zeridon/video/hardware/frontplate/README.md

# Front plate

The front plate is lasercut out of 2.5mm MDF sheets. The script below will
generate an SVG with a unique QR code for each panel, and combine 7 of them
on one sheet for easy processing.

	# requirements:
	#
	# inkscape         https://archlinux.org/packages/extra/x86_64/inkscape/
	# xmlstarlet       https://archlinux.org/packages/extra/x86_64/xmlstarlet/
	# python-qrcode    https://archlinux.org/packages/extra/any/python-qrcode/
	# python-svgutils  https://aur.archlinux.org/packages/python-svgutils
	
	# assumptions:
	# - the frontplate.svg file is a template for a front plate
	# - this template contains elements with id box-qr and box-label
	
	for i in {0..69}; do ./generate.sh A $i; done;

	max=69
	
	for i in $(seq 0 6 $max); do
		end=$(($i+5))
	
		list=""
		for j in $(seq $i $end); do
			if [ $j -gt $max ]; then
				break
			fi
	
			id=$(printf %03d $j)
			list="$list A$id"
		done
	
		./combine.py $list
	done
