zeridon/video/hardware/pcbs/audio_board/README.md

# audio board

Built-in digital audio mixer board.

* Based on the Teensy 4.1 as audio DSP
* Stereo audio input and output over USB
* Four input channels
  * 3 balanced XLR inputs for line level signals
  * One stereo 3.5mm jack with mono summing
* Four output channels
  * Two balanced XLR outputs
  * Two outputs used as stereo headphones output
