zeridon/video/graph/cabling_large_rooms.png

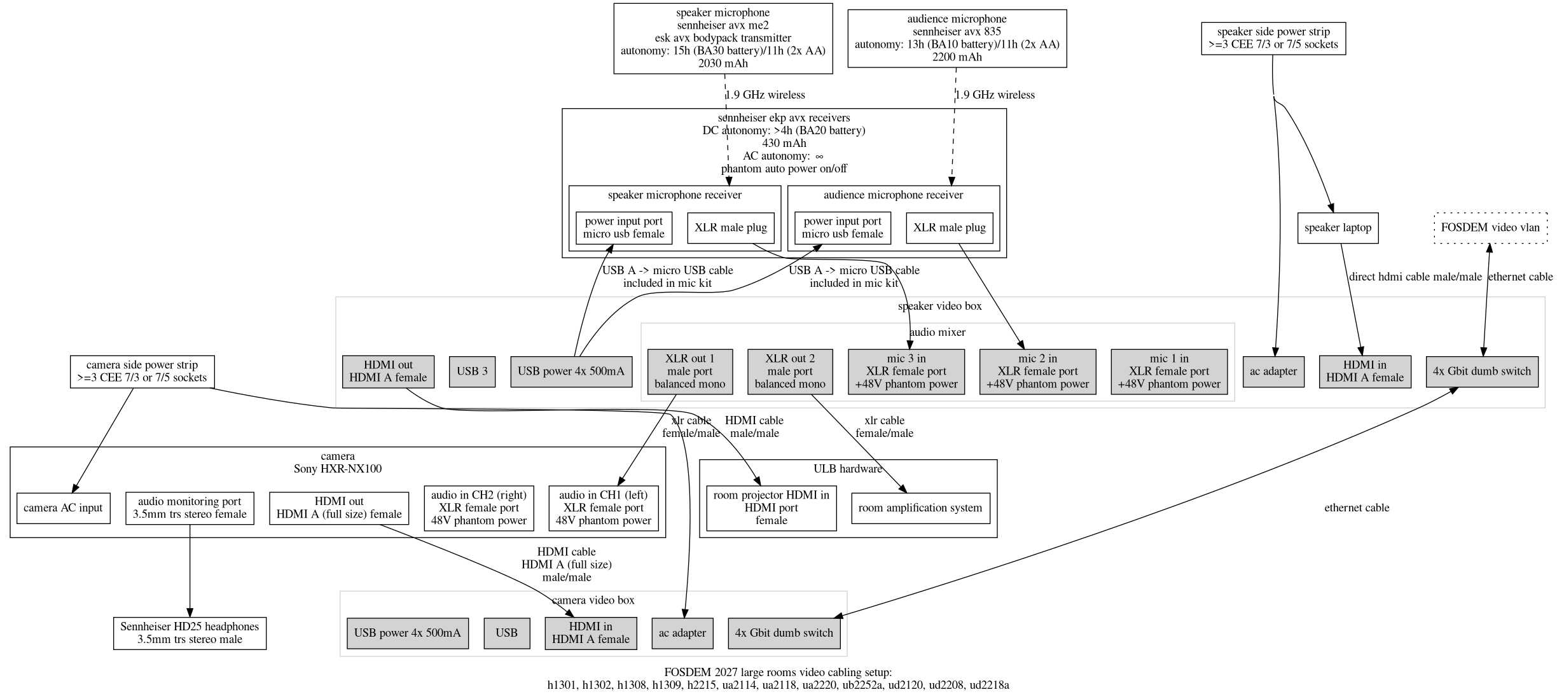
graph/cabling_large_rooms.png
