zeridon/video/graph/cabling_small_rooms.png

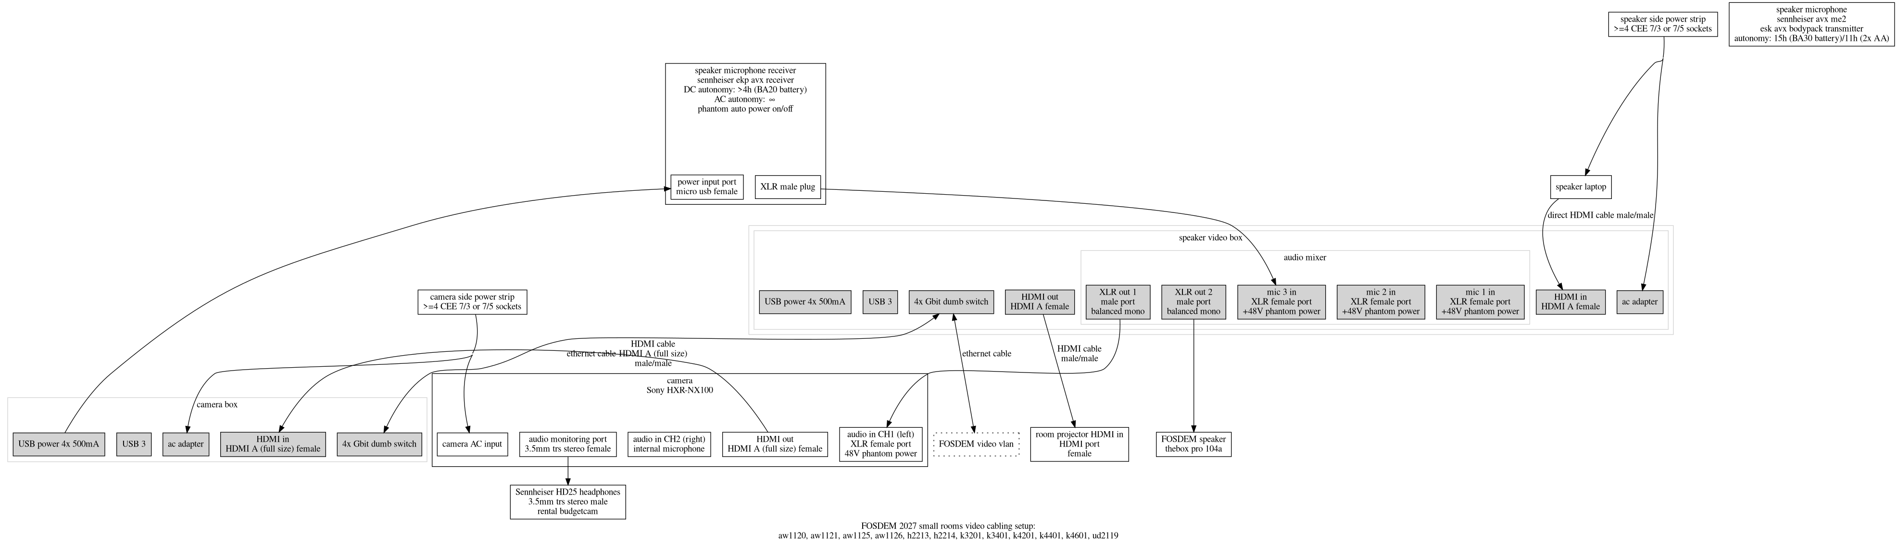
graph/cabling_small_rooms.png
