zeridon/video/graph/cabling_xxl_rooms.png

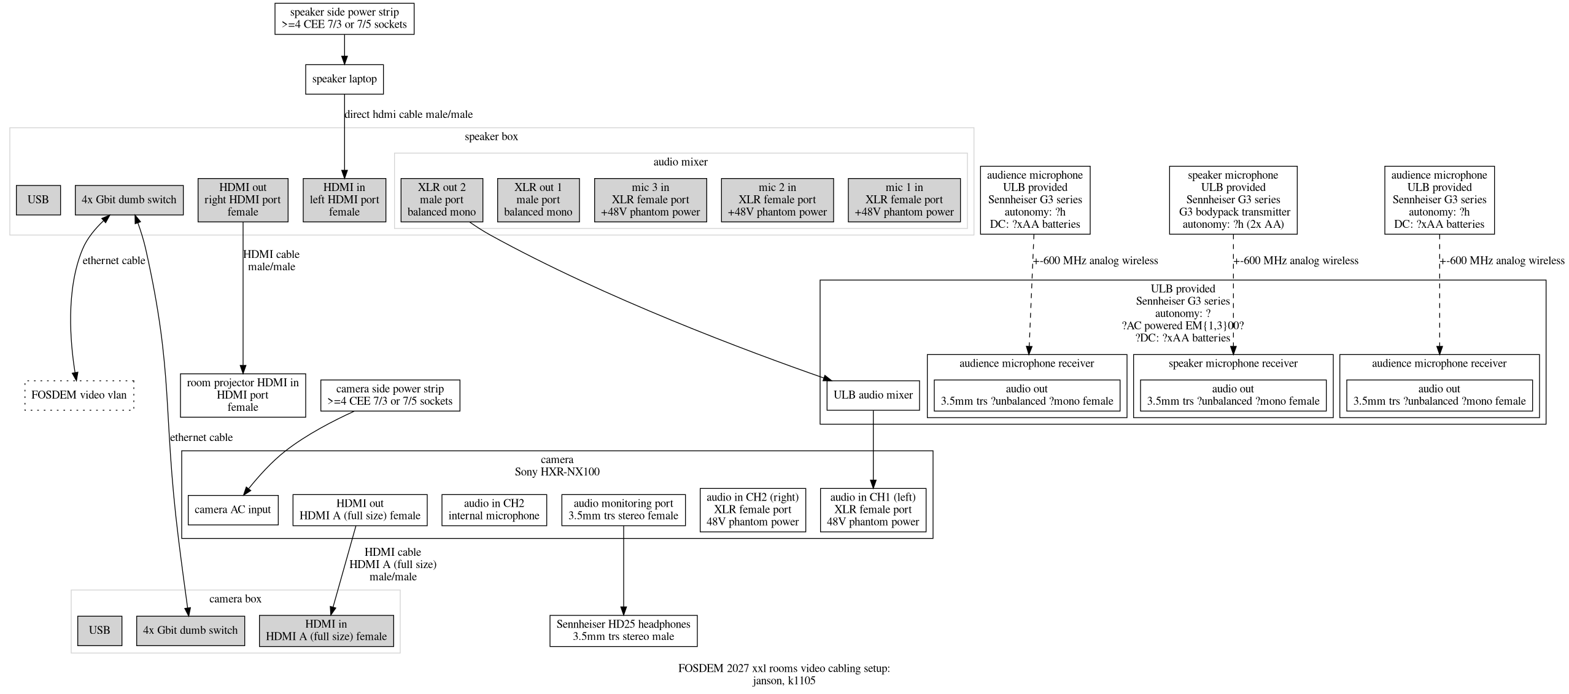
graph/cabling_xxl_rooms.png
