zeridon/video/hardware/ethernet/i2c-pinout.jpg

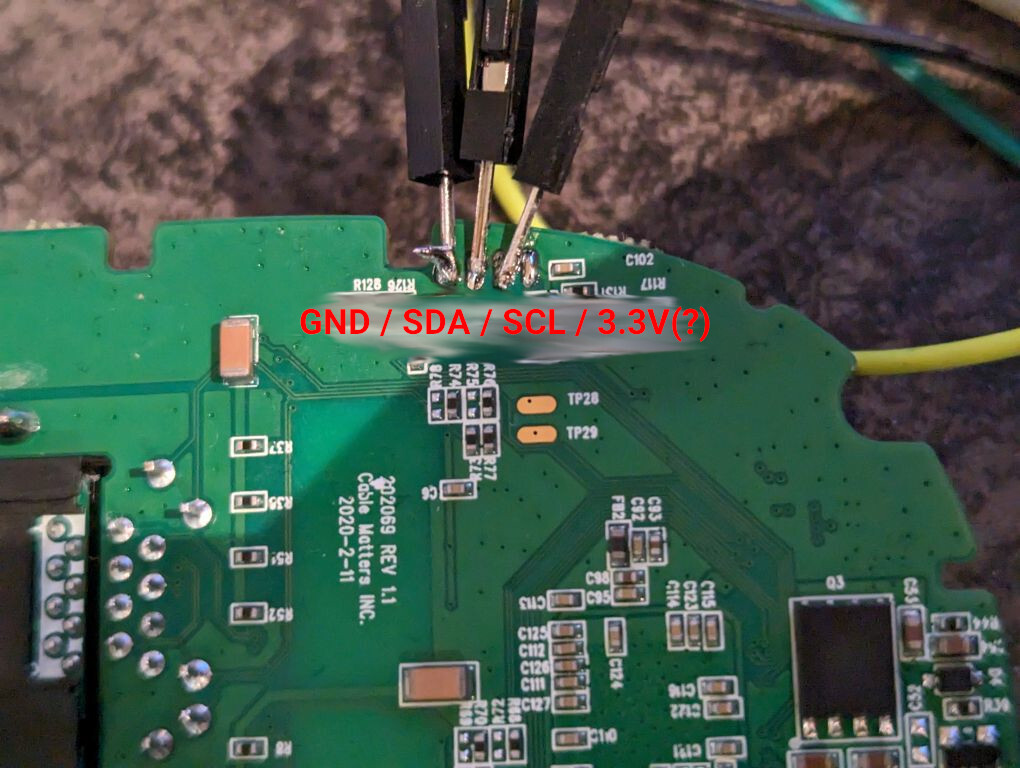
hardware/ethernet/i2c-pinout.jpg
