zeridon/video/software/processdump/postroll.jpg

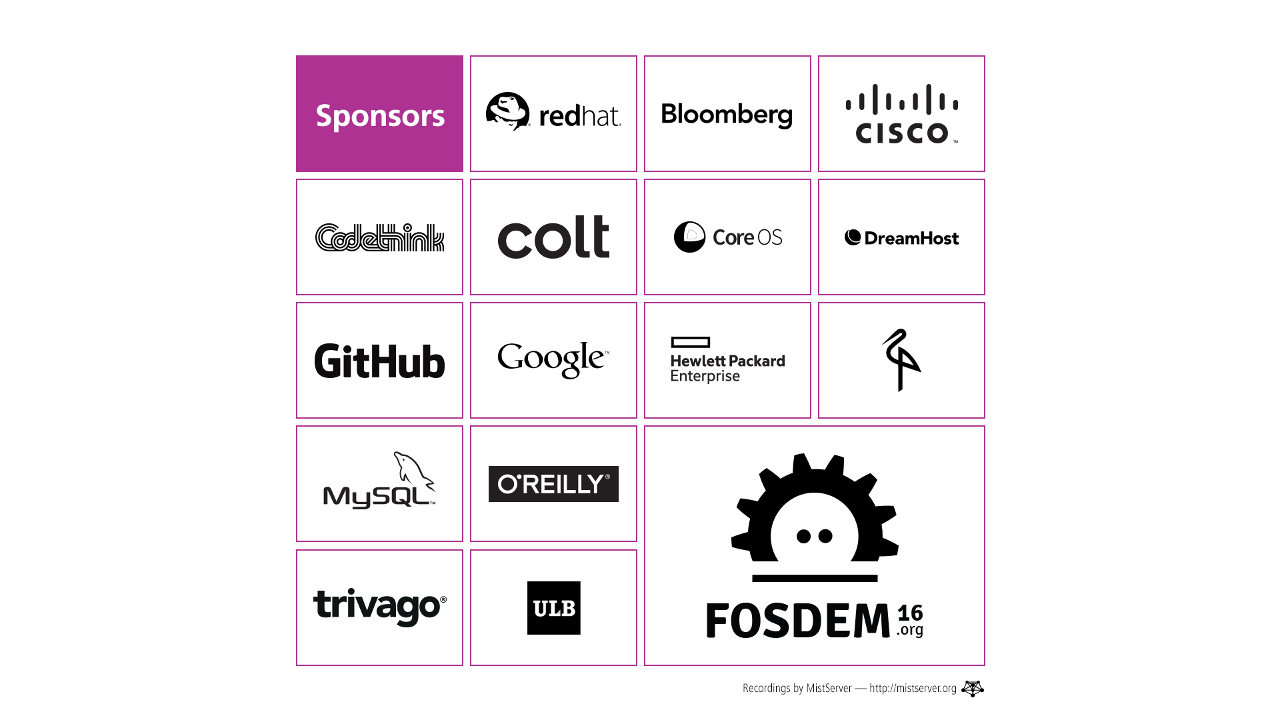
software/processdump/postroll.jpg
