zeridon/video/software/processdump/preroll.jpg

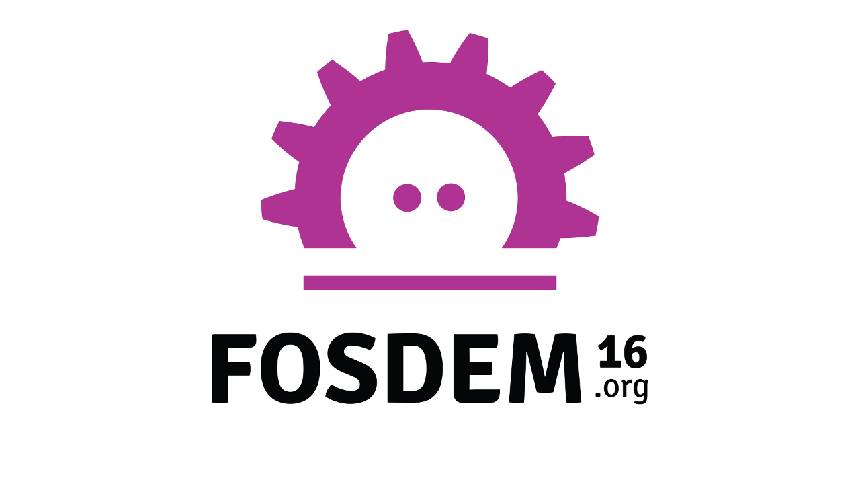
software/processdump/preroll.jpg
