zeridon/video/hardware/screenbracket/screenbracket-producton-mirror.stl

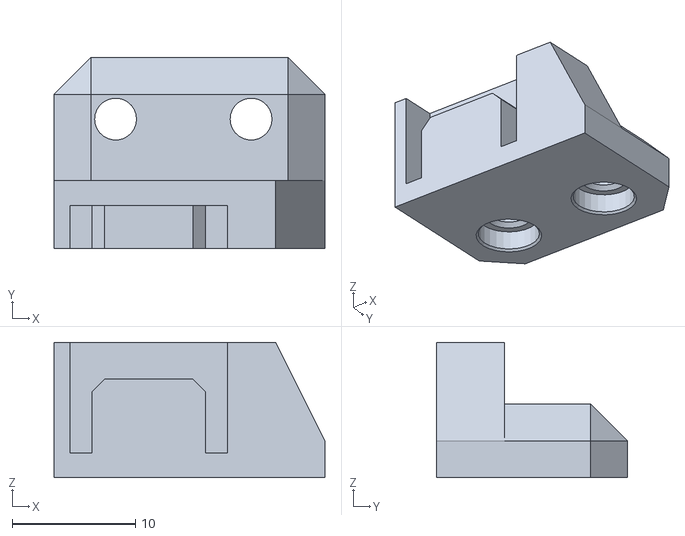
[picture p7: CAD file, 2024-12-16]
hardware/screenbracket/screenbracket-producton-mirror.stl
22.0 x 15.5 x 11.0
