zeridon/video/hardware/screenbracket/screenbracket-2.FCStd

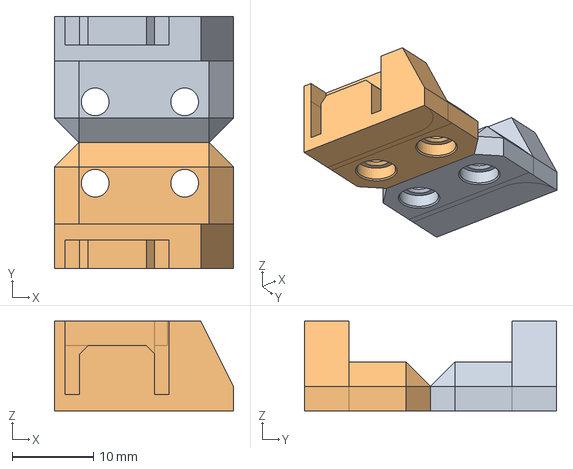
[picture p8: CAD file, 2024-12-16]
hardware/screenbracket/screenbracket-2.FCStd
22.0 x 31.0 x 11.0 mm
Cut002 (Mirror #1)
