zeridon/video/hardware/baseplate/switch_board.scad

use <nuts.scad>

module switch_holes() {
    translate([172, 100, 0]) hole_for_standoff_m3_4mm();
    translate([119,  64, 0]) hole_for_standoff_m3_4mm();
    translate([166,  64, 0]) hole_for_standoff_m3_4mm();
    translate([ 99,  99, 0]) hole_for_standoff_m3_4mm();
}

module switch() {
    brd_thickness = 1.6;
    color("#009900")
    scale([1, -1, 1])
    difference() {
        linear_extrude(brd_thickness) {
            polygon(points = [[175,142], [95,142], [94.68714,141.97538], [94.38196,141.90212], [94.09202,141.78202], [93.82442,141.61804], [93.58578,141.41422], [93.38196,141.17558], [93.21798,140.90798], [93.09788,140.61804], [93.02462,140.31286], [93,140], [93,61], [93.02462,60.68714], [93.09788,60.38196], [93.21798,60.09202], [93.38196,59.82442], [93.58578,59.58578], [93.82442,59.38196], [94.09202,59.21798], [94.38196,59.09788], [94.68714,59.02462], [95,59], [169,59], [169.31286,59.02462], [169.61804,59.09788], [169.90798,59.21798], [170.17558,59.38196], [170.41422,59.58578], [170.61804,59.82442], [170.78202,60.09202], [170.90212,60.38196], [170.97538,60.68714], [171,61], [171,92], [171.02462,92.31286], [171.09788,92.61804], [171.21798,92.90798], [171.38196,93.17558], [171.58578,93.41422], [171.82442,93.61804], [172.09202,93.78202], [172.38196,93.90212], [172.68714,93.97538], [173.0,94.0], [175,94], [175.31286,94.02462], [175.61804,94.09788], [175.90798,94.21798], [176.17558,94.38196], [176.41422,94.58578], [176.61804,94.82442], [176.78202,95.09202], [176.90212,95.38196], [176.97538,95.68714], [177,96], [177,140], [176.97538,140.31286], [176.90212,140.61804], [176.78202,140.90798], [176.61804,141.17558], [176.41422,141.41422], [176.17558,141.61804], [175.90798,141.78202], [175.61804,141.90212], [175.31286,141.97538], [175,142]]);
        }
        translate([0, 0, -1]) linear_extrude(brd_thickness+2) switch_holes();
    }
}
