zeridon/video/hardware/baseplate/baseplate.scad

use <audio_board.scad>
use <power_board.scad>
use <switch_board.scad>
use <hdmi.scad>
use <radxa_x2l.scad>
use <radxa_x4.scad>
use <onlyfans.scad>
use <display.scad>
use <case.scad>
use <nuts.scad>
use <../brackets/cable-holder.scad>
use <../brackets/standoffs-hagibi.scad>

$fn=120;


switch_transl = [187.5,53,0];
power_transl = [176.5 - 493 + 523.5, 132 - 130.5 - 60,0];
audio_transl = [170,150,0];
radxa_x2l_transl = [315,191,0];
radxa_x4_transl = [155,130,0];
hdmi_transl = [394, 195 + 3.35 - 4.4, 0];
onlyfans_transl = [0, 34.5, 0];
display_transl = [135, 0, 0];
radxa_hat_over_x4_transl = [30.8, 273.85, 10];
display_hat_transl = [141, 15, 25];

module baseplate() {
    color("#d5c5a4") linear_extrude(2) baseplate_shape();
}

module cable_holders_holes() {
    translate([220, 35, 0]) hole_for_threaded_pin_m3_8mm();
    translate([ 58, 88, 0]) hole_for_threaded_pin_m3_8mm();
    translate([125, 70, 0]) hole_for_threaded_pin_m3_8mm();
    translate([135, 88, 0]) hole_for_threaded_pin_m3_8mm();
    translate([180, 77, 0]) hole_for_threaded_pin_m3_8mm();
    translate([240, 100, 0]) hole_for_threaded_pin_m3_8mm();
    translate([334, 100, 0]) hole_for_threaded_pin_m3_8mm();
}
module cable_holders() {
    translate([220, 35, 0]) rotate([0, 0, 90]) cable_tie();
    translate([ 58, 88, 0]) rotate([0, 0, 90]) cable_tie();
    translate([125, 70, 0]) rotate([0, 0, -90]) cable_tie();
    translate([135, 88, 0]) rotate([0, 0, 90]) cable_tie();
    translate([180, 77, 0]) rotate([0, 0, 180]) cable_tie();
    translate([240, 100, 0]) rotate([0, 0, -90]) cable_tie();
    translate([334, 100, 0]) rotate([0, 0, -90]) cable_tie();
}

module baseplate_shape() {
    difference() {
        case_fit_shape();

        translate(switch_transl) rotate(180) scale([1, -1, 1]) switch_holes();
        translate(power_transl) rotate(180) scale([1, -1, 1]) power_holes();
        translate(audio_transl) scale([1, -1, 1]) audio_holes();
        // translate(radxa_x2l_transl) rotate(180) radxa_x2l_holes();
        translate(radxa_x4_transl) radxa_x4_holes();
        translate(hdmi_transl) rotate(180) hdmi_holes();
        translate(onlyfans_transl) onlyfans_cutout();
        translate(display_transl) display_cutout();
        cable_holders_holes();
    };
}

module thirdparty_boards() {
    // translate(radxa_x2l_transl) rotate(180) radxa_x2l();
    translate([0, 0, 5]) translate(radxa_x4_transl) radxa_x4();
    translate(hdmi_transl) rotate(180) hdmi();
    translate([0, 0, 0.5]) translate(hdmi_transl) rotate(180) hagibi_standoffs();
    translate([0, 0, 16]) translate(hdmi_transl) rotate(180) hdmi();
    cable_holders();
}

module boards() {
    translate(switch_transl) rotate(180) switch();
    translate(power_transl) rotate(180) power();
    translate(power_transl) rotate(180) power_old();
    translate(audio_transl) audio();
    thirdparty_boards();
    translate(onlyfans_transl) onlyfans();
    translate(display_transl) display();
}

module 3d_boards() {
    translate(switch_transl) rotate(180) import("pcb_3dmodels/switch_board.stl");
    translate(power_transl) rotate(180) import("pcb_3dmodels/power_board.stl");
    translate(audio_transl) import("pcb_3dmodels/audio_board.stl");
    translate(radxa_hat_over_x4_transl) import("pcb_3dmodels/radxa_hat.stl");
    translate(display_hat_transl) rotate([0, 90, 90]) import("pcb_3dmodels/display_hat.stl");
    thirdparty_boards();
}


module box() {
    translate([0, 0, 4 + 0.8]) 3d_boards();
    // translate([0, 0, 4]) boards();
    case();
    baseplate();
}

box();
baseplate_shape();
