zeridon/video/(list of files, cad)

Other CAD files:
hardware/screenbracket/screenbracket-producton.stl
hardware/screenbracket/screenbracket-simplified.FCStd
hardware/screenbracket/screenbracket.FCStd
hardware/brackets/washer.scad
hardware/baseplate/hdmi.scad
hardware/brackets/onlyfans-baseplate.scad
