zeridon/video/hardware/wiring/README.md

# Wiring

The wiring has been documented using
[WireViz](https://github.com/wireviz/WireViz).

To compile, run `wireviz wiring.yml`.

Once [#325](https://github.com/wireviz/WireViz/issues/325) has been
resolved, we should move to whatever they decided on instead of the
hack using `tweaks`.
