zeridon/video/instructions/flight_cases_content.md

## per flight case
- #15 hdmi cables
- #5 3-way power
- #10 C14 power cables

## per room
- 1 battery & adapter bag
  - #1 usb charger
  - #1 usb a-> micro usb cable arbitrary length
  -  #1 usb battery bank, charged
  - #2 usb a- micro usb cable 2m
  - #1 adapter usb-c -> hdmi
  - #1 adapter mini dp -> hdmi
  - #1 adapter dp -> hdmi

Before FOSDEM:
- reinventorise and resupply
- recharge and test all usb battery banks
