zeridon/video/hardware/wiring/wiring.txt

                                                             W == wire (~28 AWG)                                                                                           
                                                             T == thick wire (~0.5 mm2)                                                                                    
                                                                                                                                                                           
                                                                                                                                                                           
                                                                                                                                                                           
                                                     barrel                  onlyfans                                                                                      
                                                 ┌──────────┐              ┌────────────────────────────┐                                                                  
                                                 │          │              │                            │                                                                  
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
                                                       │                                         │                                                                         
                                                       │                                         │                                                                         
                                                       │                                         │                                                                         
                                                       │                                         │                                                                         
                                                       │                                         │                                                                         
                                                       │                                         │                                                                         
                                                       └─────────────────────────────────────────┘
