zeridon/video/instructions/fosdem2024/speakers.md

*** THIS IS A LIVING DOCUMENT. PLEASE CHECK BACK OFTEN OR SUBSCRIBE TO THE CHANGES! ***
# FOSDEM 2024 video: speakers manual

## Before FOSDEM
### Slides: technical requirements
Please create slides with a 16/9 aspect ratio. 1920x1080 (recommended) or 1280x720 (acceptable) will do.

You may want to keep a copy with 4/3 aspect ratio handy for best results should the room projector in your room have a native 4/3 resolution. 1280x960 will do.

### Matrix account
As a speaker, you might want a Matrix account.  You should already have been invited by email (or Matrix, if we know your Matrix ID) to sign up to Matrix and join the relevant chatrooms.  If not, you can get a Matrix account at https://chat.fosdem.org.  Then, to receive the invites, please enter your Matrix ID (e.g. @matthew:fosdem.org) under your account details on [https://pretalx.fosdem.org](https://pretalx.fosdem.org/fosdem-2024/me/) (look for the 'Matrix-id' field) and you'll be invited shortly. We send out invites a few times a day.

You should be invited to:
 * [#speakers:fosdem.org](https://matrix.to/#/#speakers:fosdem.org) (the main coordination point for speakers)
 * The backstage room for your devroom, where you can coordinate with the devroom organisers and your hosts
 * The devroom itself.

## During FOSDEM
### Slides capture
The slides capture system will accept hdmi input. Please bring your own whatever-to-hdmi adapter should you need any. Adapters for mini-dp, usb-c and possibly more will be provided on a best effort basis.

Please mind the following requirements:
- 60 Hz or lower video output refresh rate
- 1080p (1920x1080) or lower output resolution

### Talk Q&A: live audience interaction and text based questions from chat.fosdem.org
You will have a chance to address your real life live audience's questions in a live broadcast q&a session. Your room manager or his assistant may also relay questions from https://chat.fosdem.org .

- You may want to join the following rooms:
  - [#speakers:fosdem.org](https://chat.fosdem.org/#/room/#speakers:fosdem.org)
    - This room is invite only. It's accessible to all speakers and FOSDEM staff.
    - You should have received an invitation by email. In case you have trouble getting in, any FOSDEM staff should be able to invite you here.
  - the general audience room for your talk.
    - You should have received an invitation to this room.
    - Alternatively, you can derive your matrix room from the [schedule](https://fosdem.org/schedule/events/). Examples: D.cloud => [#cloud-devroom:fosdem.org](https://chat.fosdem.org/#/room/#cloud-devroom:fosdem.org), M.misc => [#misc:fosdem.org](https://chat.fosdem.org/#/room/#misc:fosdem.org) .
  
### Help! Something is wrong. Who do I contact?
- For practical issues regarding projection, capture and sound inside your room, live people in green FOSDEM video t-shirts are your best bet. There is one team per building:
  - [AW building](https://nav.fosdem.org/l/aw1125/): room AW1.125
  - [H building](https://nav.fosdem.org/l/h2-infodesk/): H2.111
  - [J/Janson auditorium](https://nav.fosdem.org/l/janson/): near the audio mixing console, by the camera
  - [K1.105 "Lafontaine" main track auditorium](): near the camera, if not see K general
  - [K building](https://nav.fosdem.org/l/c:1:165.69:265.77/): behind the 1.105 ("Lafontaine") auditorium, bottom left when facing the stage
  - [UD building](https://nav.fosdem.org/l/ud2119/): room UD2.119
  - [UB building](https://nav.fosdem.org/l/ub4228/): room UB4.228 
- Alternatively, you may contact video volunteers through the dedicated matrix [video channel](https://chat.fosdem.org/#/room/#fosdem-video:matrix.org).
- For issues regarding the stream on https://fosdem.org site in general, please also email both [video@fosdem.org](mailto:video@fosdem.org) and [server@fosdem.org](mailto:server@fosdem.org) .
- I have a problem connecting to https://chat.fosdem.org at all.
  - Speak to anyone in a blue (FOSDEM developer room manager), green (FOSDEM video) or yellow (FOSDEM staff) t-shirt.

## After your talk & after FOSDEM
When agreeing to speak at FOSDEM, you explicitly granted FOSDEM vzw the right to publish your video under a CC BY-SA license. Your video will be uploaded to the FOSDEM video archive at https://video.fosdem.org .

### Video review
Your developer room manager, one of his delegates and/or you should receive a [video review](https://review.video.fosdem.org) link by email. There, you can indicate proper start and end points for your talk video to be released at https://video.fosdem.org .
