zeridon/video/hardware/wiring/resources/fan.jpg

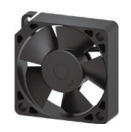
hardware/wiring/resources/fan.jpg
