zeridon/video/hardware/wiring/resources/hdmi.jpg

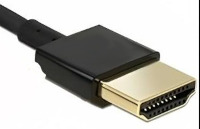
hardware/wiring/resources/hdmi.jpg
