zeridon/video/hardware/wiring/resources/mta100-te-3-643814-4.jpg

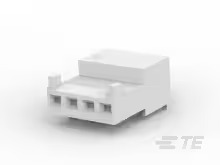
hardware/wiring/resources/mta100-te-3-643814-4.jpg
