zeridon/video/hardware/wiring/resources/mta100-te-3-643814-8.jpg

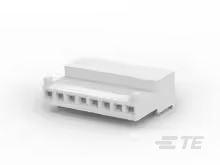
hardware/wiring/resources/mta100-te-3-643814-8.jpg
