zeridon/video/hardware/wiring/resources/naked-2w.jpg

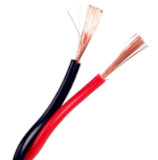
hardware/wiring/resources/naked-2w.jpg
