zeridon/video/hardware/wiring/resources/panel-dc-socket.jpg

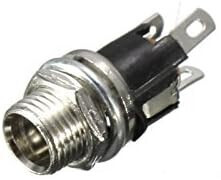
hardware/wiring/resources/panel-dc-socket.jpg
