zeridon/video/hardware/wiring/resources/rj45.jpg

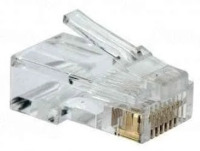
hardware/wiring/resources/rj45.jpg
