zeridon/video/hardware/wiring/resources/usb2-a.jpg

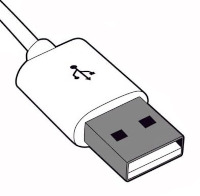
hardware/wiring/resources/usb2-a.jpg
