zeridon/video/hardware/wiring/resources/usb2-micro-b.jpg

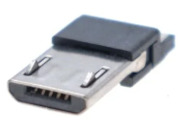
hardware/wiring/resources/usb2-micro-b.jpg
