zeridon/video/hardware/wiring/resources/usb3-c.jpg

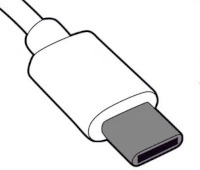
hardware/wiring/resources/usb3-c.jpg
