zeridon/video/hardware/wiring/resources/usb3-micro-b.jpg

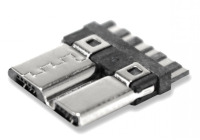
hardware/wiring/resources/usb3-micro-b.jpg
