zeridon/video/instructions/sources/Cam00.jpg

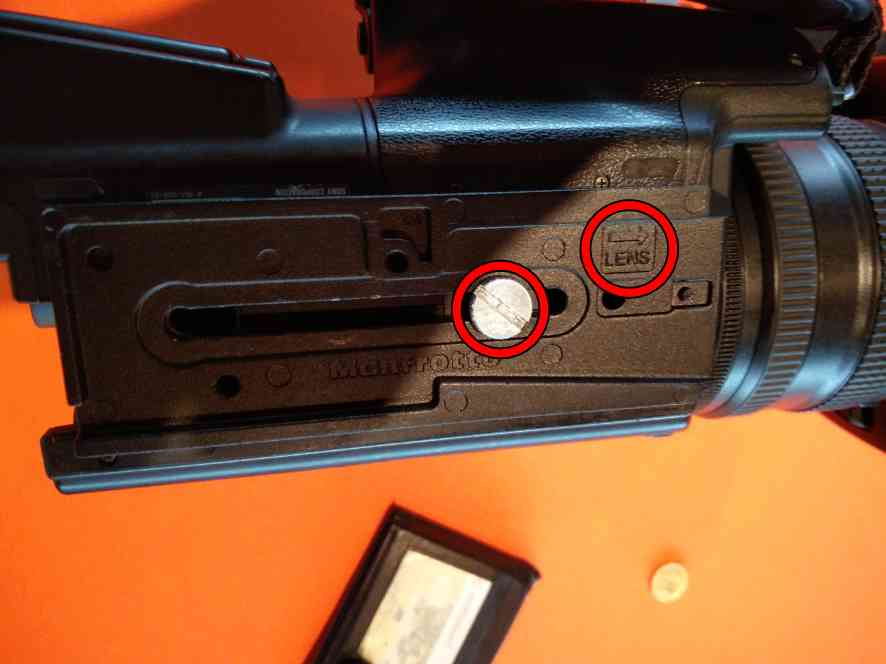
instructions/sources/Cam00.jpg
