zeridon/video/instructions/sources/control.video.png

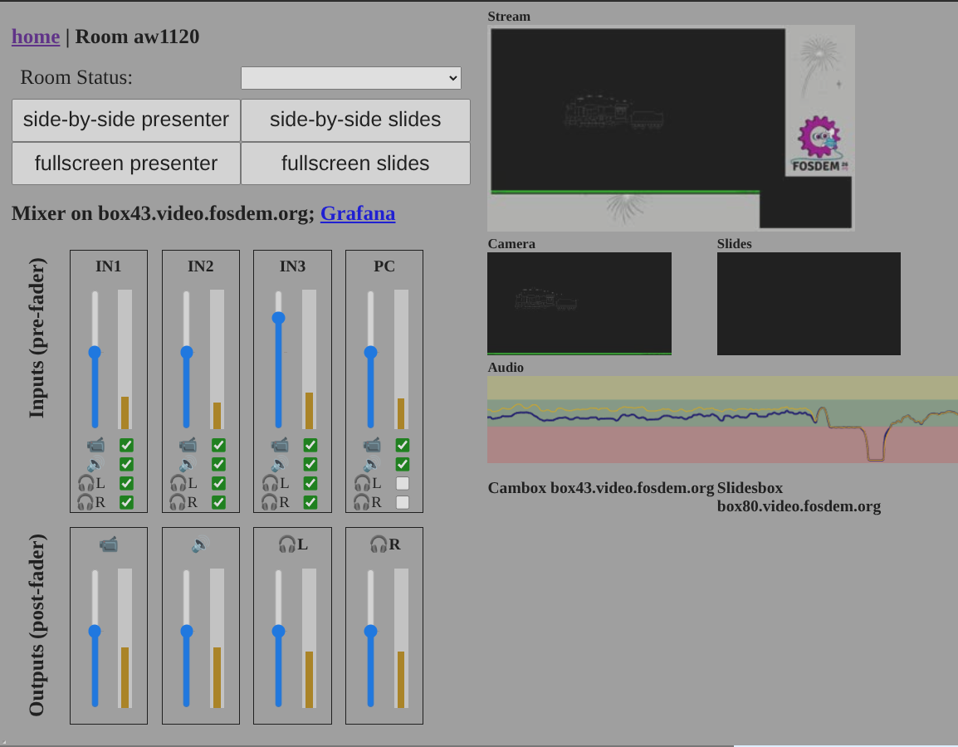
instructions/sources/control.video.png
