zeridon/video/instructions/sources/lcd_status.jpg

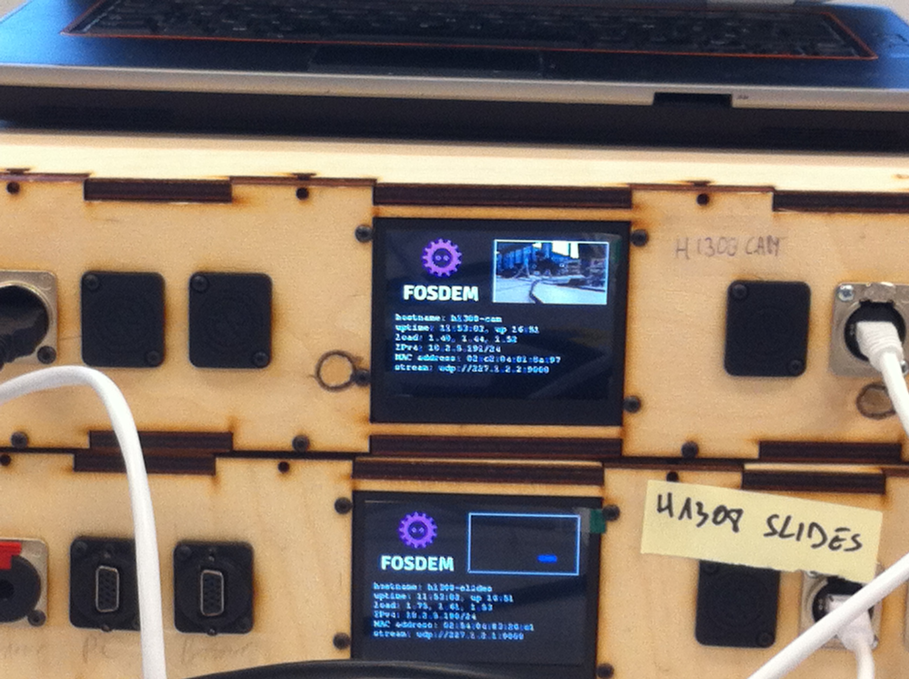
instructions/sources/lcd_status.jpg
