zeridon/video/instructions/sources/monitoring_screen.jpg

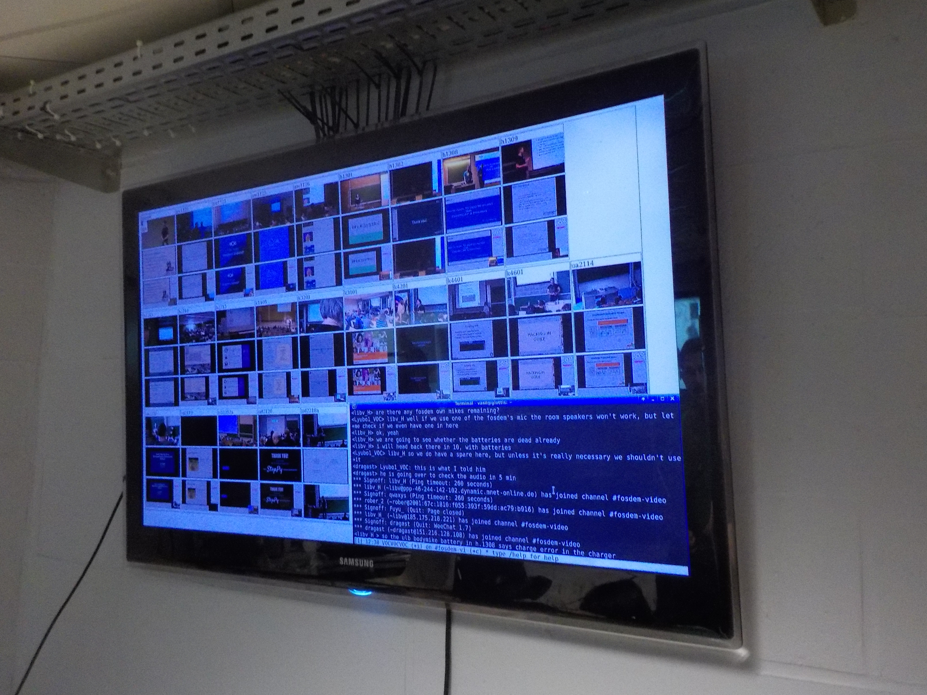
instructions/sources/monitoring_screen.jpg
