zeridon/video/instructions/sources/paired_avx.jpg

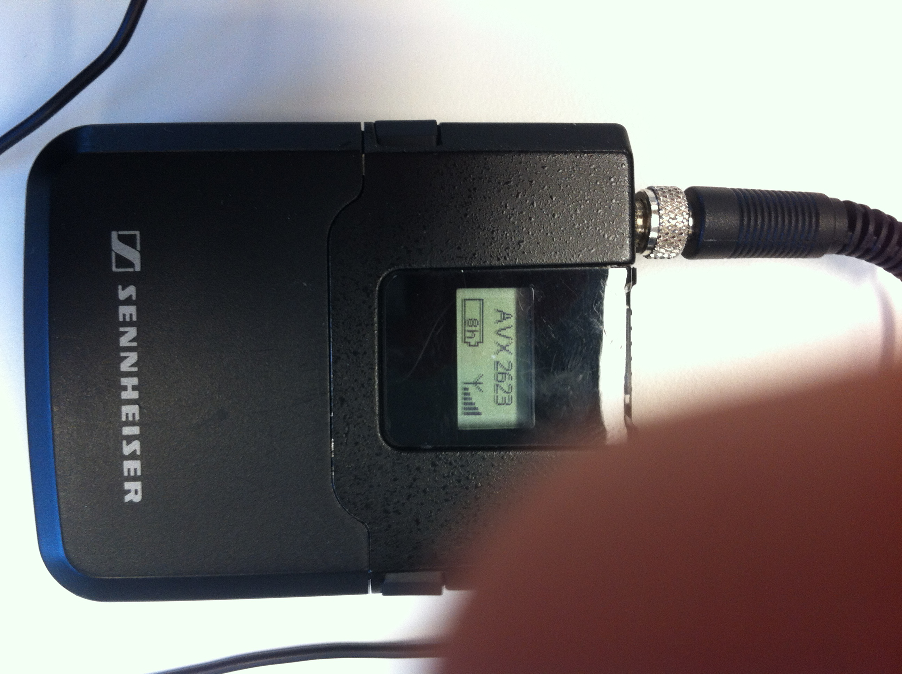
instructions/sources/paired_avx.jpg
