zeridon/video/instructions/sources/render_farm.jpg

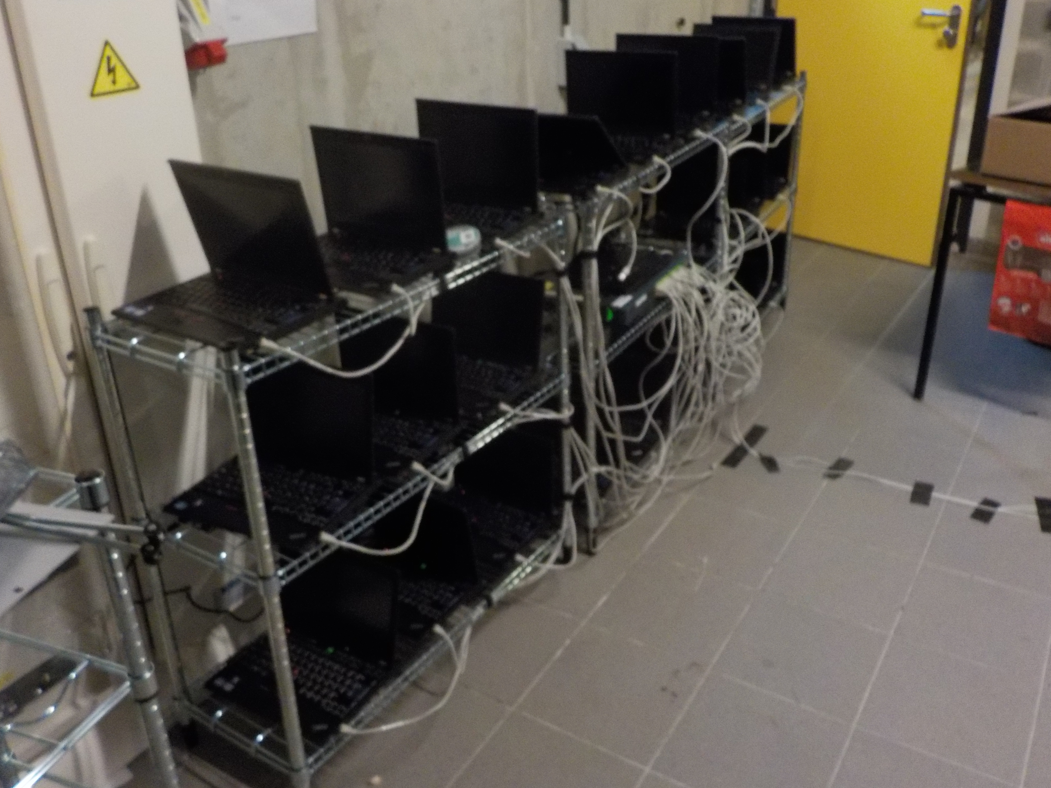
instructions/sources/render_farm.jpg
