zeridon/video/instructions/sources/showbuilding.png

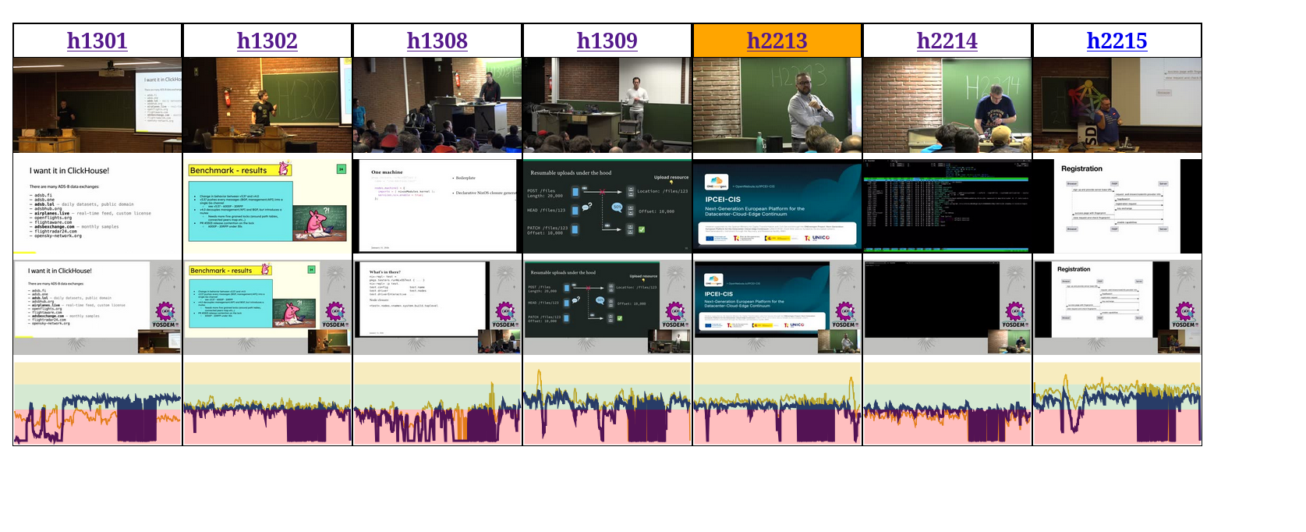
instructions/sources/showbuilding.png
