zeridon/video/instructions/sources/Sony01.jpg

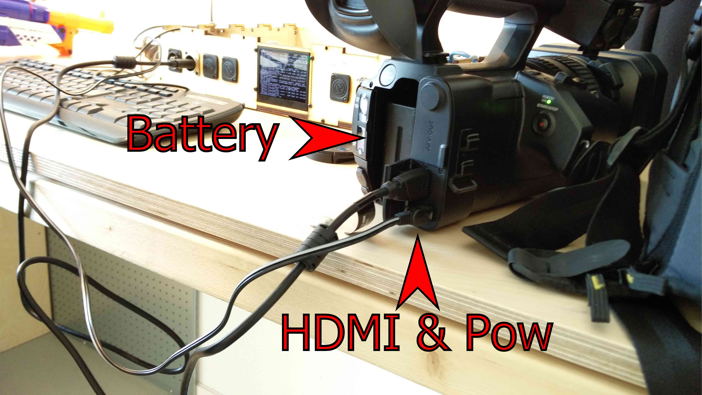
instructions/sources/Sony01.jpg
