zeridon/video/instructions/sources/Sony04.jpg

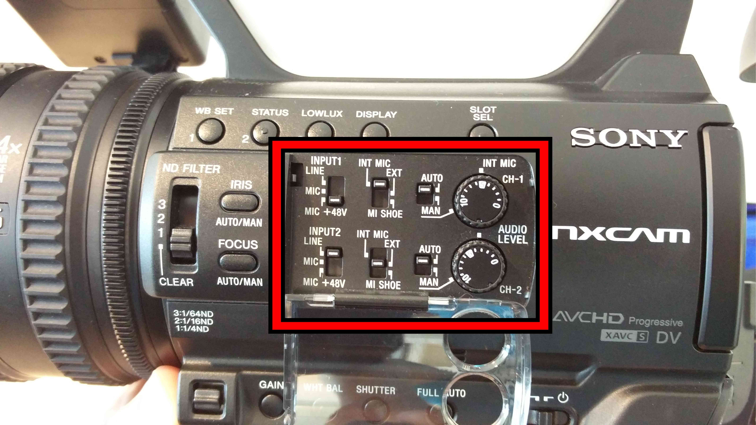
instructions/sources/Sony04.jpg
