zeridon/video/instructions/sources/Sony05.jpg

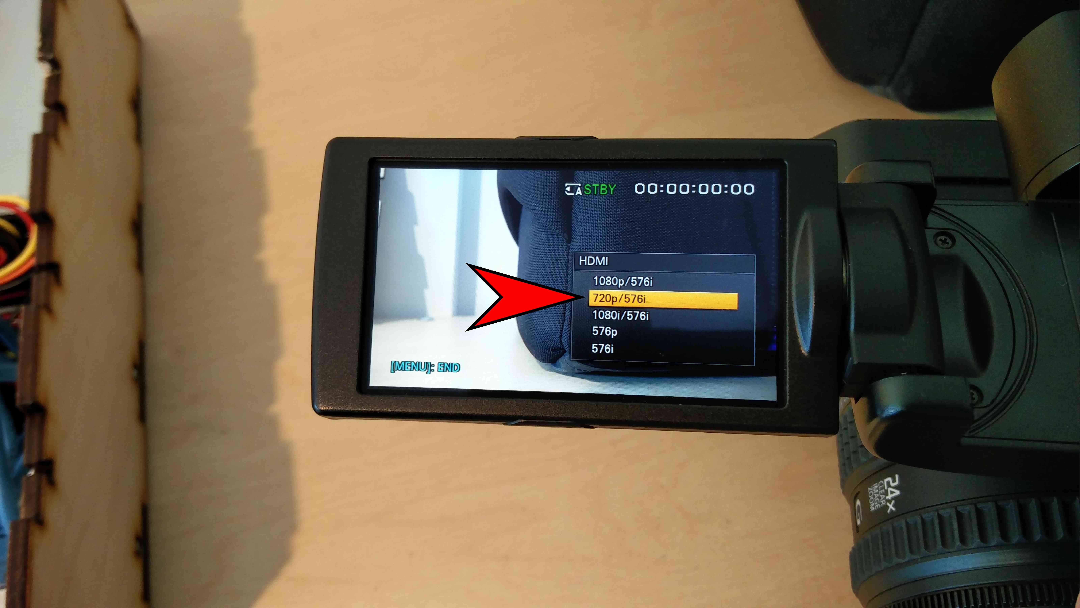
instructions/sources/Sony05.jpg
