zeridon/video/instructions/sources/Sony06.jpg

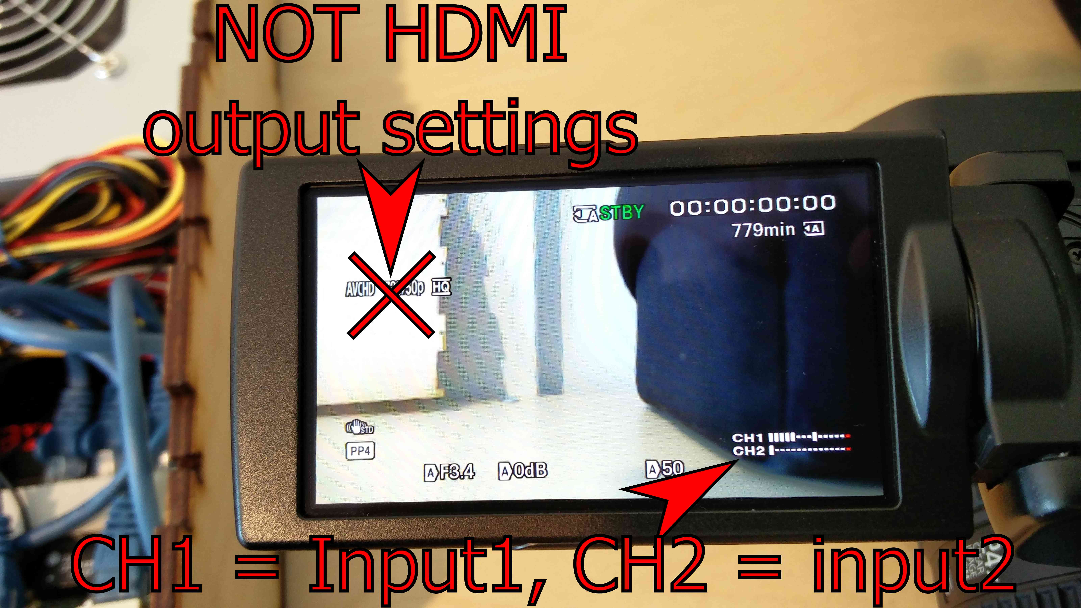
instructions/sources/Sony06.jpg
