zeridon/video/instructions/sources/sony_audio_settings.jpg

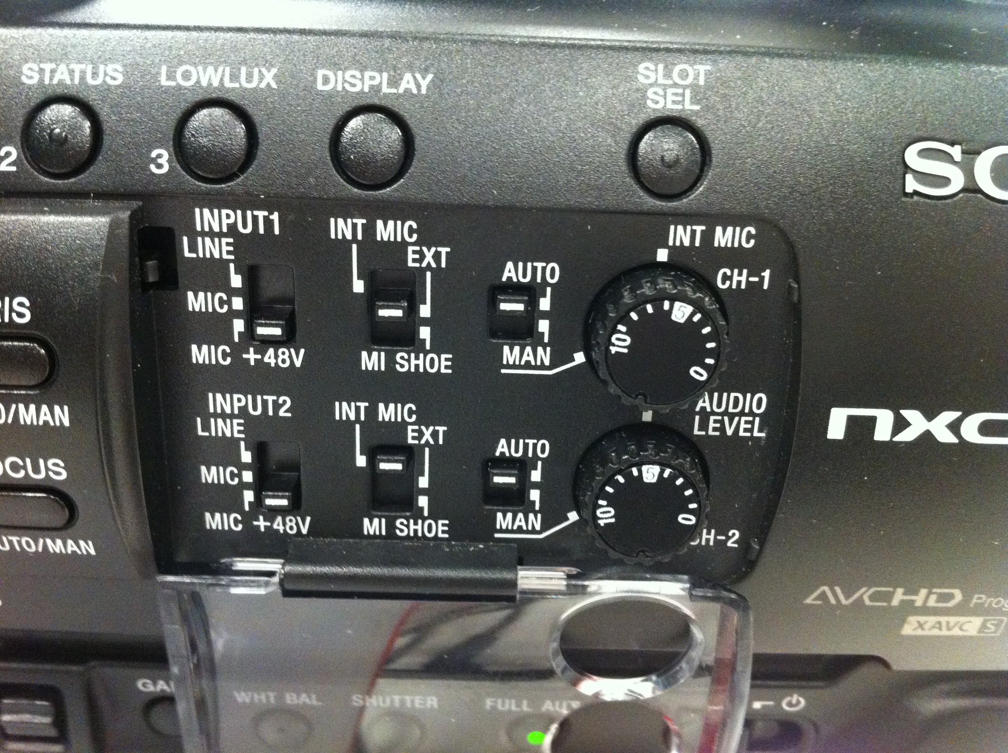
instructions/sources/sony_audio_settings.jpg
