zeridon/video/instructions/sources/sony_connect_xlr.jpg

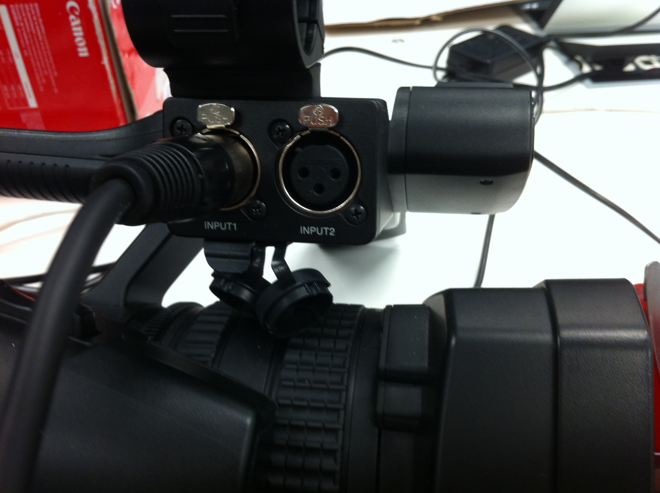
instructions/sources/sony_connect_xlr.jpg
