zeridon/video/graph/overview.pdf

## Room

# FOSDEM video, overview schema

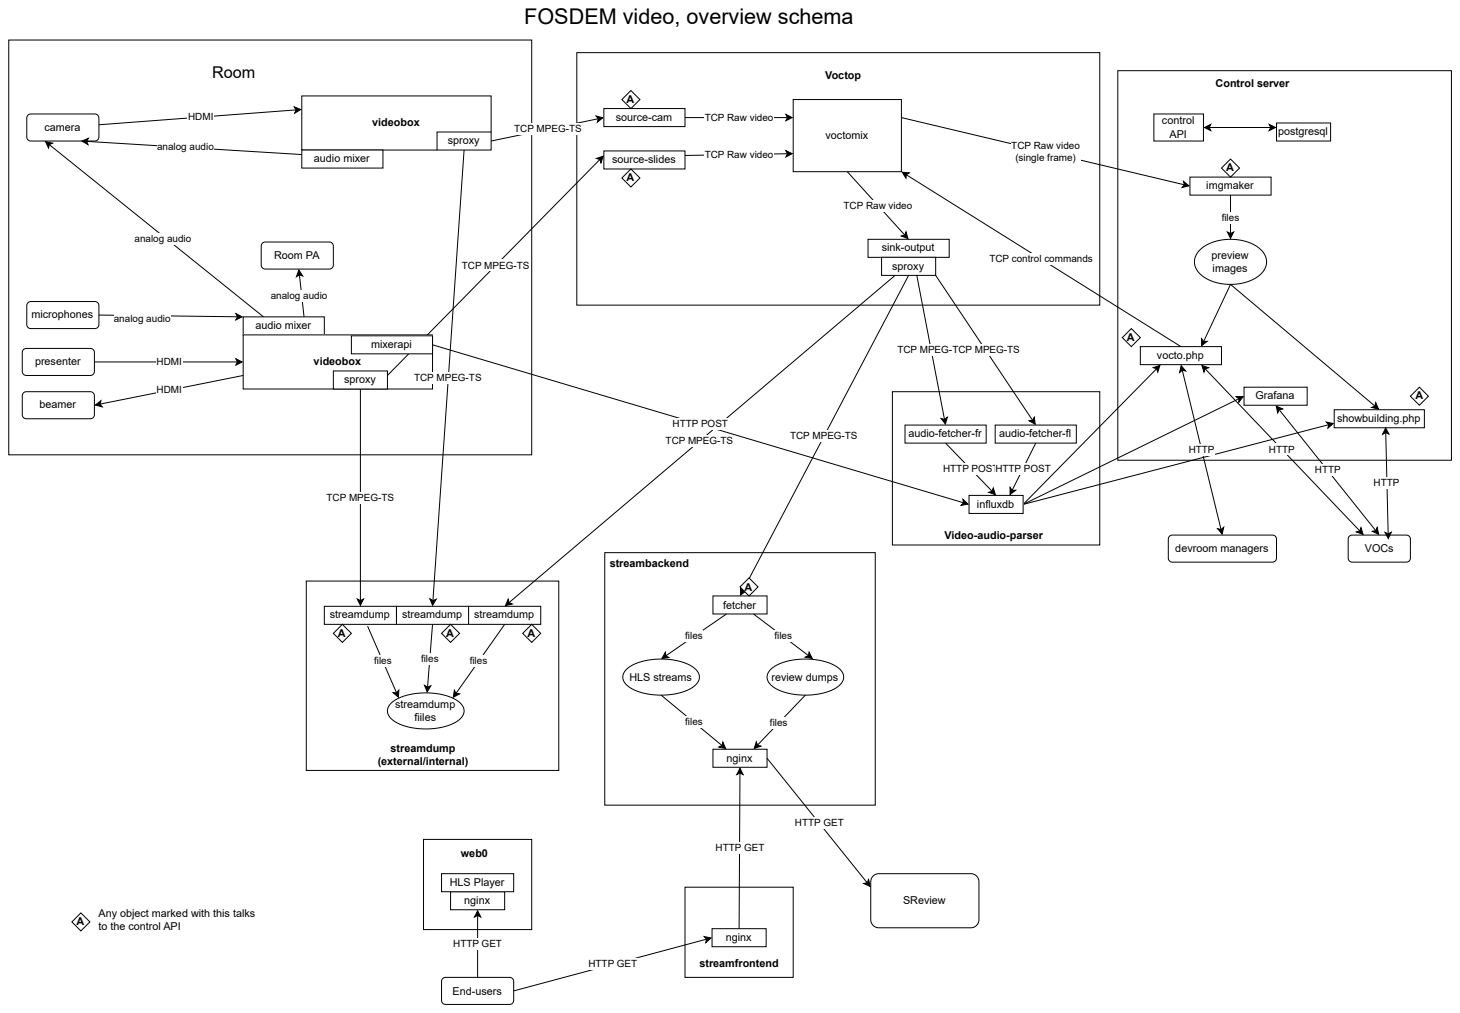
[picture p70: page 1]
camera; videobox HDMI; audio mixer; Room PA; microphones; analog audio; sproxy; voctomix TCP MPEG-TS; source-cam; source-slides; presenter; HDMI; videobox; beamer; sink-output sproxy; Voctop; HTTP POST; imgmaker; preview images; files; vocto.php; showbuilding.php; fetcher; HLS streams; review dumps; nginx; HTTP GET; streamdump; streamdump fiiles; SReview; End-users; HLS Player; Grafana; control; API; postgresql; Control server; streambackend; streamfrontend; web0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

TCP Raw video

(single frame)

TCP MPEG-TS

TCP control commands

TCP MPEG-TSCP MPEG-TS

HTTP POST

audio-fetcher-fr

audio-fetcher-fl

Video-audio-parser

Any object marked with this talks
to the control API

## Room setup, detailed

## Camera box

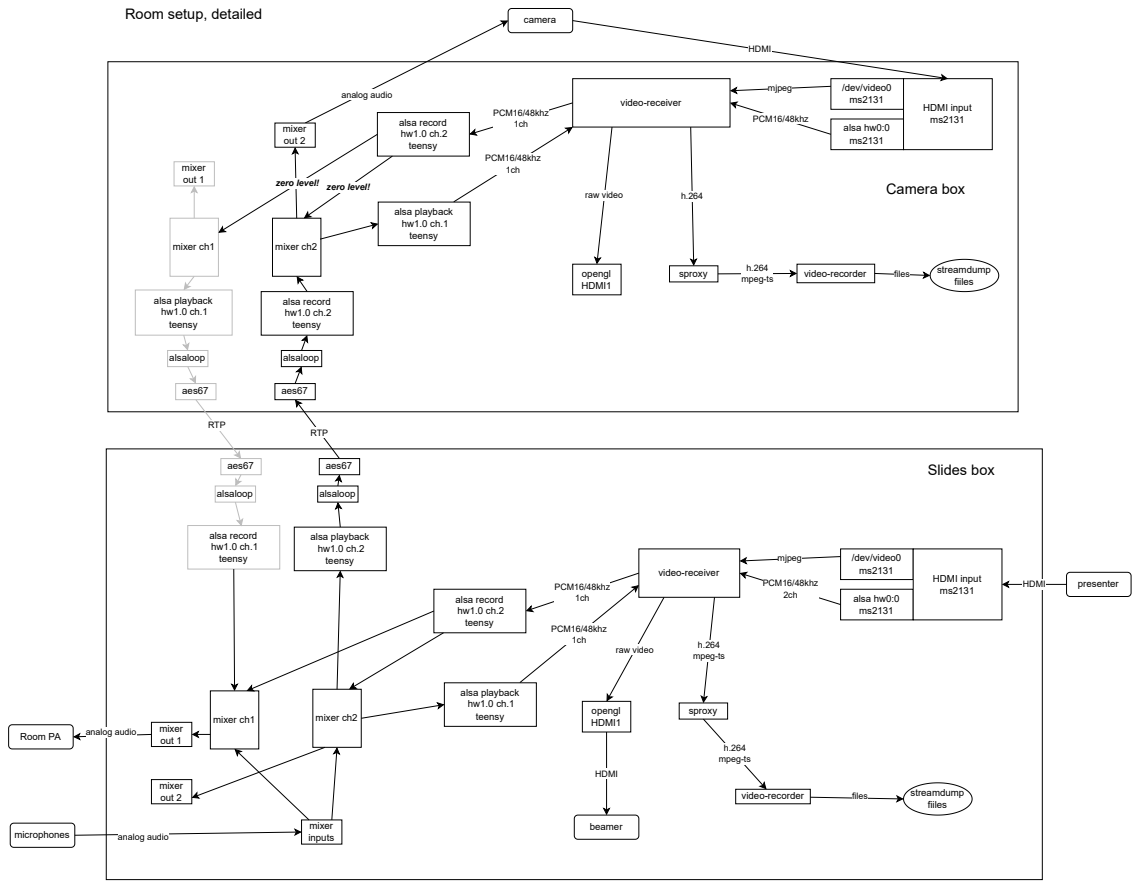
[picture p71: page 2]
sproxy; video-receiver; /dev/video0 ms2131; mjpeg; aes67; alsa hw0:0 ms2131; PCM16/48khz; opengl HDMI1; raw video; alsa playback hw1.0 ch.1 teensy; alsa record hw1.0 ch.2 teensy; mixer ch1; mixer ch2; microphones; analog audio; camera; HDMI input ms2131; HDMI; RTP; alsaloop; PCM16/48khz 2ch; h.264 mpeg-ts; alsa record hw1.0 ch.1 teensy; alsa playback hw1.0 ch.2 teensy; presenter; beamer; Room PA; mixer out 2; mixer out 1; mixer inputs; Slides box; alsa record; hw1.0 ch.2 teensy; video-recorder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

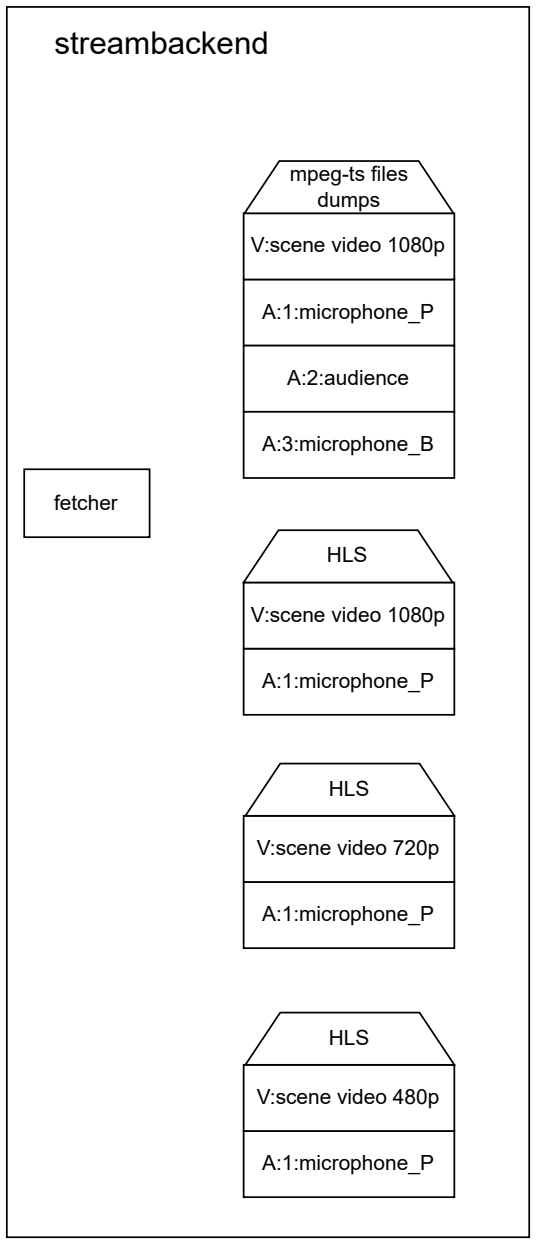
[picture p72: figure]
fetcher; A:1:microphone_P; V:scene video 1080p; A:2:audience; A:3:microphone_B; V:scene video 720p; V:scene video 480p; HLS; mpeg-ts files dumps; streambackend
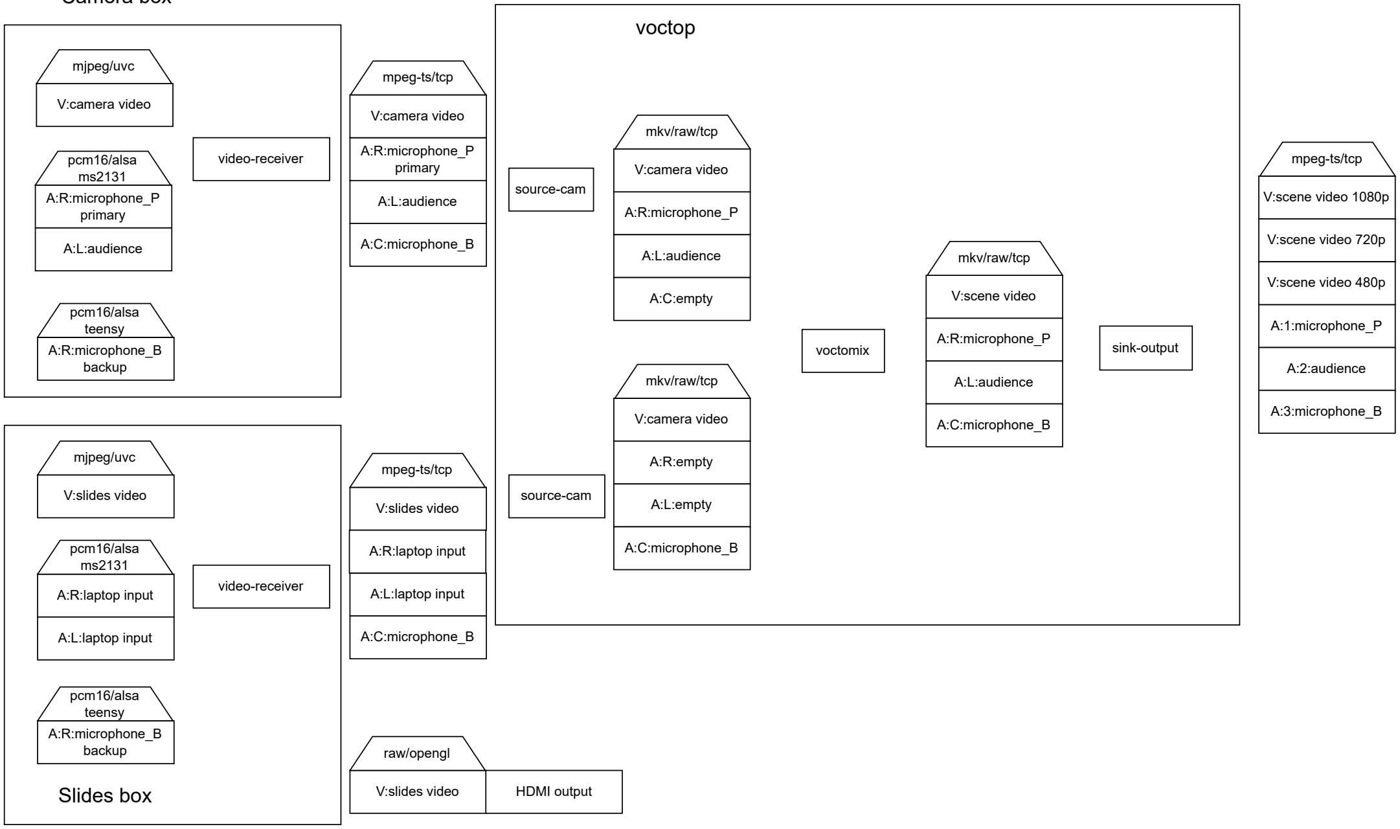
[picture p73: figure]
A:R:microphone_P primary; V:camera video; A:L:audience; V:slides video; A:L:laptop input; source-cam; A:R:microphone_P; A:C:empty; A:R:empty; A:L:empty; A:C:microphone_B; voctomix; sink-output A:R:microphone_P; V:scene video; A:1:microphone_P; V:scene video 1080p; A:2:audience; A:3:microphone_B; V:scene video 720p; V:scene video 480p; mpeg-ts/tcp; mkv/raw/tcp; video-receiver; mjpeg/uvc; pcm16/alsa ms2131; A:R:laptop input; A:R:microphone_B backup; pcm16/alsa teensy; voctop; Slides box; raw/opengl; HDMI output

## Camera box

## How do the streams look like and where they go
