zeridon/video/graph/fosdem-video-2017.pdf

## control

## voctop-ROOM

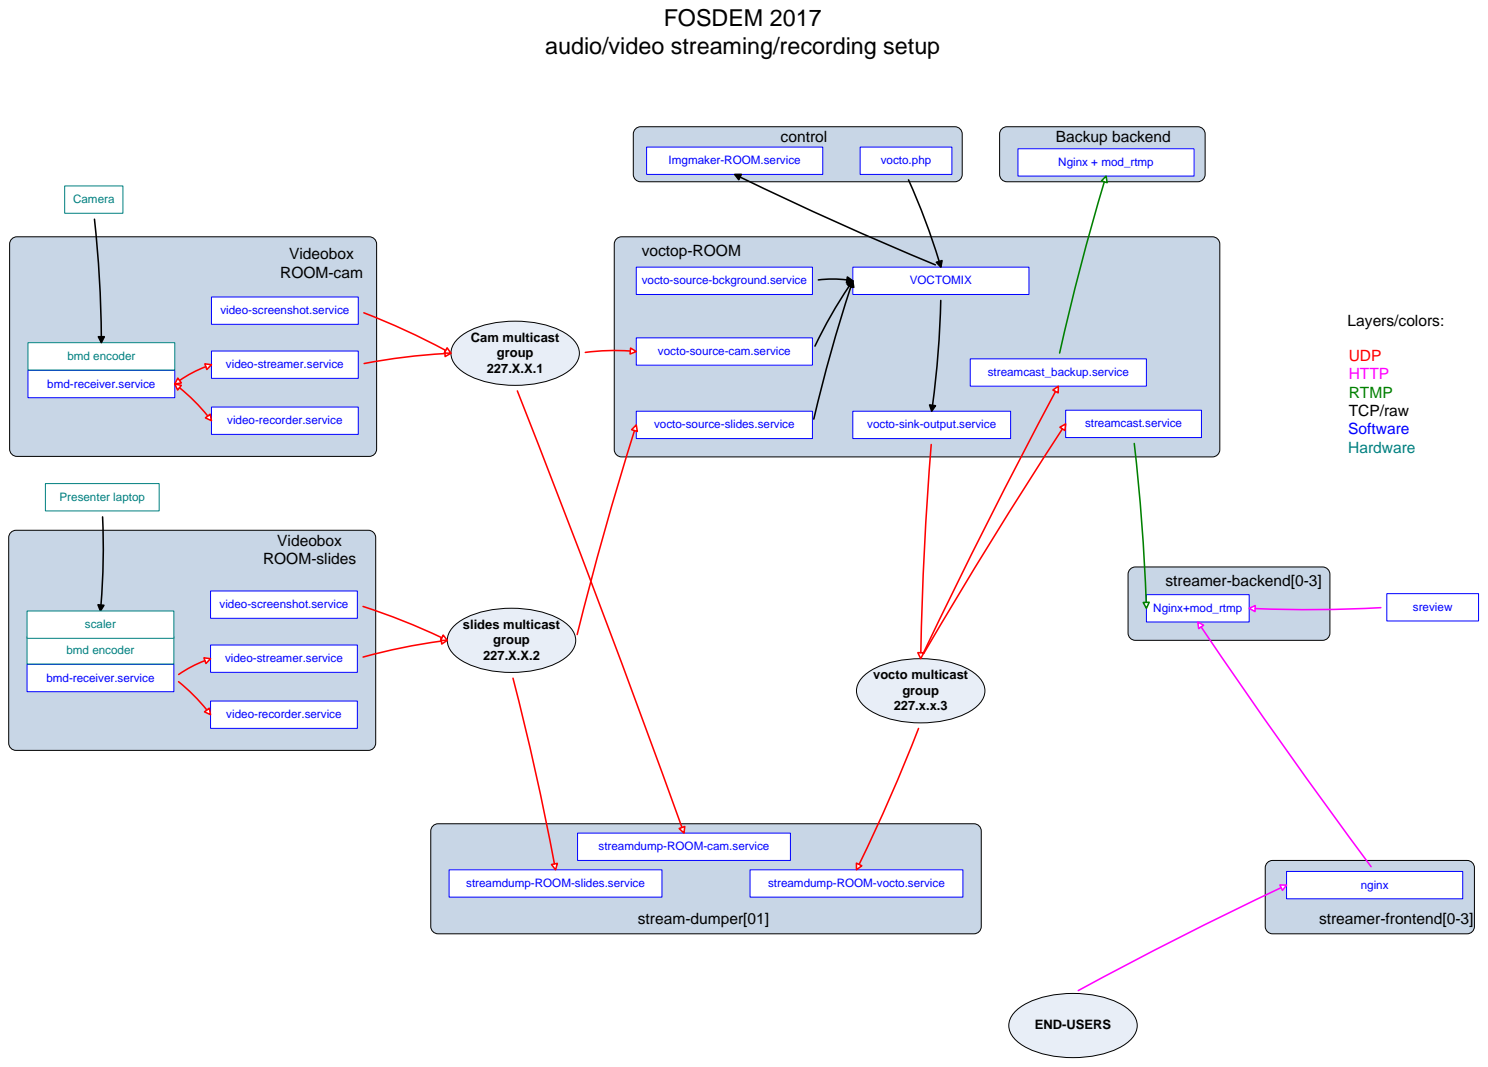
[picture p74: page 1]
stream-dumper[01]; streamer-frontend[0-3]; streamer-backend[0-3]; Backup backend; Cam multicast group 227.X.X.1; Videobox ROOM-cam; Camera; bmd encoder; Presenter laptop; slides multicast group 227.X.X.2; scaler; Videobox ROOM-slides; VOCTOMIX; streamcast_backup.service; streamcast.service; vocto multicast group 227.x.x.3; Nginx+mod_rtmp; Nginx + mod_rtmp; nginx; Imgmaker-ROOM.service; vocto.php; sreview; streamdump-ROOM-slides.service; streamdump-ROOM-vocto.service; END-USERS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

audio/video streaming/recording setup

vocto-source-bckground.service

video-screenshot.service

vocto-source-cam.service

video-streamer.service

bmd-receiver.service

video-recorder.service

vocto-source-slides.service

vocto-sink-output.service

streamdump-ROOM-cam.service
