zeridon/video/hardware/firmware/box_rp2040/src/pwr_brd_ctl/fan_ctl_regs.h

const uint8_t EMC2301_REG_FANSTATUS            = 0x24;
const uint8_t EMC2301_REG_PWMBASEFREQ          = 0x2D;
const uint8_t EMC2301_REG_FANSETTING           = 0x30;
const uint8_t EMC2301_REG_PWMDIVIDE            = 0x31;
const uint8_t EMC2301_REG_FANCONFIG1           = 0x32;
const uint8_t EMC2301_REG_FANCONFIG2           = 0x33;
const uint8_t EMC2301_REG_FANSPINUP            = 0x36;
const uint8_t EMC2301_REG_FANMAXSTEP           = 0x37;
const uint8_t EMC2301_REG_FANMINDRIVE          = 0x38;
const uint8_t EMC2301_REG_FANVALTACHCOUNT      = 0x39;
const uint8_t EMC2301_REG_TACHTARGETLSB        = 0x3C;
const uint8_t EMC2301_REG_TACHTARGETMSB        = 0x3D;
const uint8_t EMC2301_REG_TACHREADMSB          = 0x3E;
const uint8_t EMC2301_REG_TACHREADLSB          = 0x3F;

/* Registers that can have values written directly into them (i.e. the entire register is meant for a single number):
    EMC2301_REG_FANSETTING
    EMC2301_REG_PWMDIVIDE
    EMC2301_REG_FANMAXSTEP (Max 0b00111111 or 0x3F or 63)
    EMC2301_REG_FANMINDRIVE
    EMC2301_REG_FANVALTACHCOUNT (The final value from this register is 32 x (value in register))
    EMC2301_REG_TACHTARGETLSB and EMC2301_REG_TACHTARGETMSB (MUST write both LSB and MSB, with LSB written before MSB)
*/

// EMC2301_REG_PWMBASEFREQ
const uint8_t EMC2301_REG_PWMBASEFREQ_26KHZ  = 0x00;
const uint8_t EMC2301_REG_PWMBASEFREQ_19KHZ  = 0x01;
const uint8_t EMC2301_REG_PWMBASEFREQ_4KHZ   = 0x02;
const uint8_t EMC2301_REG_PWMBASEFREQ_2KHZ   = 0x03;

// EMC2301_REG_FANCONFIG1
const uint8_t EMC2301_REG_FANCONFIG1_RPMCONTROL    = 0x80;
const uint8_t EMC2301_REG_FANCONFIG1_MINRPM_CLEAR  = ~0x60;
const uint8_t EMC2301_REG_FANCONFIG1_MINRPM_500    = 0x00;
const uint8_t EMC2301_REG_FANCONFIG1_MINRPM_1000   = 0x20;
const uint8_t EMC2301_REG_FANCONFIG1_MINRPM_2000   = 0x40;
const uint8_t EMC2301_REG_FANCONFIG1_MINRPM_4000   = 0x60;
const uint8_t EMC2301_REG_FANCONFIG1_FANPOLES_CLEAR  = ~0x18;
const uint8_t EMC2301_REG_FANCONFIG1_FANPOLES_1    = 0x00;
const uint8_t EMC2301_REG_FANCONFIG1_FANPOLES_2    = 0x08;
const uint8_t EMC2301_REG_FANCONFIG1_FANPOLES_3    = 0x10;
const uint8_t EMC2301_REG_FANCONFIG1_FANPOLES_4    = 0x18;
const uint8_t EMC2301_REG_FANCONFIG1_UPDATE_CLEAR    = ~0x07;
const uint8_t EMC2301_REG_FANCONFIG1_UPDATE_100    = 0x00;
const uint8_t EMC2301_REG_FANCONFIG1_UPDATE_200    = 0x01;
const uint8_t EMC2301_REG_FANCONFIG1_UPDATE_300    = 0x02;
const uint8_t EMC2301_REG_FANCONFIG1_UPDATE_400    = 0x03;
const uint8_t EMC2301_REG_FANCONFIG1_UPDATE_500    = 0x04;
const uint8_t EMC2301_REG_FANCONFIG1_UPDATE_800    = 0x05;
const uint8_t EMC2301_REG_FANCONFIG1_UPDATE_1200   = 0x06;
const uint8_t EMC2301_REG_FANCONFIG1_UPDATE_1600   = 0x07;

// EMC2301_REG_FANCONFIG2
const uint8_t EMC2301_REG_FANCONFIG2_RAMPCONTROL   = 0x40;
const uint8_t EMC2301_REG_FANCONFIG2_GLITCHFILTER  = 0x20;
const uint8_t EMC2301_REG_FANCONFIG2_DEROPT_CLEAR    = ~0x18;
const uint8_t EMC2301_REG_FANCONFIG2_DEROPT_NONE   = 0x00;
const uint8_t EMC2301_REG_FANCONFIG2_DEROPT_BASIC  = 0x08;
const uint8_t EMC2301_REG_FANCONFIG2_DEROPT_STEP   = 0x10;
const uint8_t EMC2301_REG_FANCONFIG2_DEROPT_BOTH   = 0x18;
const uint8_t EMC2301_REG_FANCONFIG2_ERRRANGE_CLEAR  = ~0x06;
const uint8_t EMC2301_REG_FANCONFIG2_ERRRANGE_0    = 0x00;
const uint8_t EMC2301_REG_FANCONFIG2_ERRRANGE_50   = 0x02;
const uint8_t EMC2301_REG_FANCONFIG2_ERRRANGE_100  = 0x04;
const uint8_t EMC2301_REG_FANCONFIG2_ERRRANGE_200  = 0x06;

// EMC2301_REG_FANSPINUP
const uint8_t EMC2301_REG_FANSPINUP_NOKICK           = 0x20;
const uint8_t EMC2301_REG_FANSPINUP_SPINLVL_CLEAR      = ~0x1C;
const uint8_t EMC2301_REG_FANSPINUP_SPINLVL_30       = 0x00;
const uint8_t EMC2301_REG_FANSPINUP_SPINLVL_35       = 0x04;
const uint8_t EMC2301_REG_FANSPINUP_SPINLVL_40       = 0x08;
const uint8_t EMC2301_REG_FANSPINUP_SPINLVL_45       = 0x0C;
const uint8_t EMC2301_REG_FANSPINUP_SPINLVL_50       = 0x10;
const uint8_t EMC2301_REG_FANSPINUP_SPINLVL_55       = 0x14;
const uint8_t EMC2301_REG_FANSPINUP_SPINLVL_60       = 0x18;
const uint8_t EMC2301_REG_FANSPINUP_SPINLVL_65       = 0x1C;
const uint8_t EMC2301_REG_FANSPINUP_SPINUPTIME_CLEAR   = ~0x03;
const uint8_t EMC2301_REG_FANSPINUP_SPINUPTIME_250   = 0x00;
const uint8_t EMC2301_REG_FANSPINUP_SPINUPTIME_500   = 0x01;
const uint8_t EMC2301_REG_FANSPINUP_SPINUPTIME_1000  = 0x02;
const uint8_t EMC2301_REG_FANSPINUP_SPINUPTIME_2000  = 0x03;

// EMC2301_REG_FANMAXSTEP
const uint8_t EMC2301_REG_FANMAXSTEP_MAX = 0b00111111;
