zeridon/video/hardware/firmware/audio_board/src/teensyaudio_defaults.h

#pragma once

#include "channel_info.h"

extern const float    default_bus_volumes_dB[BUSES];
extern const float    default_channel_input_gains_dB[CHANNELS];
extern const uint16_t default_mutes[BUSES];
extern const uint16_t default_phantoms;
extern const float    default_matrix_dB[CHANNELS][BUSES];
