zeridon/video/(commit log)

2016-03-06 Updated box wirings, added description of hardware components.
2016-08-15 Commit for streaming the bmd device to display
2016-08-26 Enabled SSD mountpoint
2016-11-13 Switch to directfb
2016-11-16 Add a config file, update streaming scritps.
    Currently all the config is taken from a variable that's copy-paste from
    the README.md in ansible, which is ugly and needs to be changed.
    All the configuration is based on the hostname of the vocto, with the
    following conventions:
    * there is a ROOMNAME.restream.fosdem.org, where the stream needs to be sent,
    and it's a single server
    * the recordings go in a directory and are named with ROOMNAME.TIMESTAMP.ts,
    where TIMESTAMP is the unix timestamp of when the recording was started.
    * the multicast groups end in .1 for cam, and .2 for presenter box.
2016-11-16 use superior quality and speed aac encoder
2016-11-18 Replace the config/config.sh in the containers
    The values in /opt/config/config.sh in the containers are now set via
    the clone tasks file. I liked this idea better, because now all vocto
    container config is in the voctohost.yml config file.
    Sorry Vasil, I hope you weren't too attached to your beautiful script.
2016-11-18 Configure the host mount in the containers
2016-11-27 remove superfluous print statement
2016-12-03 add room names, update camera type
2016-12-04 phantom power!
2016-12-05 add power outlets, network uplink, ...
2016-12-05 avx receivers phantom power on/off
2016-12-10 Ensure the video disk gets mounted properly
2016-12-10 Add noatime to the mount options
2016-12-10 fix streaming ouput - left channel is the speaker, right channel is the camera internal microphone
2016-12-10 Template architecture variables
    Template variables for armv7l vs x86_64.
    * Go architecture
    * Kernel package
    Also install a couple useful utilities.
2016-12-10 manual updates, mostly canon and avx camera settings
2016-12-10 switch to ipv6 multicast groups. also, why isn't there 'm' in hex.
2016-12-10 switch to ipv6 multicast groups for ansible
2016-12-10 Revert "switch to ipv6 multicast groups. also, why isn't there 'm' in hex."
    This reverts commit 64fadaed59e2489afd7cebb3fe5e7e4fd9b481d9.
2016-12-10 Revert "switch to ipv6 multicast groups for ansible"
    This reverts commit 6c7bafee8fef04c84a6e6263926dfdd2be59ba77.
2016-12-16 switch to udp multicast sink
2016-12-22 add aac robustness filter
2016-12-27 set I frame every 45 frames
2017-01-17 Work around the fact that we're faking things
    Currently, we're using files (for testing purposes) that we claim start
    at a different point in time than they actually do. This works, but now
    that detect_files is ran every so often, the endtimes get set to some
    time before the starttimes, which means our tests break.
    Fix it up by, when updating, using the starttime as found in the
    database rather than as just parsed out of the filename, so that we
    don't have any further problems anymore
2017-02-01 make the complex filtergraph actually work
2017-02-03 Update to current situation
2017-02-07 Schematics for the video setup of FOSDEM 2017
2019-12-23 Update video box location, remove old devices
2020-01-30 manual: Hint that mic should be unmuted
    Some mics power up muted, so add hint that this should be checked as well.
    It happened to us once, the first talk got recorded without sound… which is embarrassing.
2022-11-20 software: one-liner to generate dhcpd config
    I got really tired of reimplementing this every year. Hope I remember
    it for next...
2023-06-13 videofazant: usb-c brackets
    [usbc-bracket-front.scad, usbc-bracket.scad, usbc-bracket.stl]
2023-06-13 videofazant: better fit of the usb-c bracket
    [usbc-bracket-front.scad]
2023-06-17 made first version of bracket for ethernet-device assuing 3mm screws and ylon rondell
    [ether-barcket.stl, ether-bracket.FCStd]
2023-06-17 added lasercut frontplate trial version
2023-06-17 Don't store binary files
    [usbc-bracket.stl]
2023-06-17 Finetune USB-C hub mounting bracket
    [usbc-bracket.scad]
2023-06-17 Case lock v1
    [case-lock.scad]
2023-06-17 ethernet switch barcket
    [ether-bracket-version2.FCStd]
2023-07-09 case-lock: adjust dimensions for a tighter fit
    [case-lock.scad]
2023-07-10 Re-do the ether-bracket in OpenSCAD
    [ether-bracket-version3.scad]
2023-07-10 As printed on Ender-A
    [ether-bracket-version3.scad]
2023-07-10 Add quick version
    [ether-bracket-version3.scad]
2023-07-10 add strain relief
    [ether-bracket-version3.scad]
2023-07-11 ether-bracket: tweak, split common parts off to modules
    [ether-bracket-version3.scad, letter.scad, standembracer.scad]
2023-07-11 usb-c-bracket: first attempt at a front part
    [usb-c-bracket.scad]
2023-07-14 more progress on the usb-c bracket
    [usb-c-bracket.scad]
2023-07-17 usb-c bracket: production ready
    [usb-c-bracket.scad]
2023-07-17 cleanup of videofazant
    [ether-barcket.stl, ether-bracket-version2.FCStd, ether-bracket.FCStd, ether-bracket.scad, usbc-bracket-front.scad, usbc-bracket.scad, usbc-bracket.stl]
2023-07-19 ether-bracket: remove version from print
    [ether-bracket.scad]
2023-07-19 Add capture board bracket & a simple 10mm washer
    [capture-bracket.scad, washer.scad]
2023-07-26 usb-c bracket: larger screwholes, adjust pad
    The pad was blocking the USB-C connector from going all the way in.
    [usb-c-bracket.scad]
2023-07-26 washer: thicker washers so 6mm screws will fit
    The threaded screwpads in the cases are 4mm deep, we need 2mm washers
    to make these fit tightly. Also used a 12mm diameter because why not.
    [washer.scad]
2023-08-06 videofazant: remove obsolete bits
    [ether-bracket-version2.FCStd, ether-bracket.FCStd, usbc-bracket-front.scad, usbc-bracket.scad]
2023-08-06 videofazant: document washer and case-lock
    [case-lock.scad, washer.scad]
2023-08-06 videofazant: tweak the USB-C bracket
    * Move the whole board 4mm closer to the front (doesn't need
    modifications to the fins in the case)
    * Add a protective bit on the underside, protecting the board from
    things poking into it through the fins
    * Enlarge the transversal bar to fit over the now longer front
    * Add a protrusion around the USB-C opening, fitting neatly between
    the fins of the case
    [usb-c-bracket.scad]
2023-08-06 videofazant: document capture bracket
    [capture-bracket.scad]
2023-08-06 videofazant: tweak ether bracket
    * Move the entire board 1mm closer to the front, making it sit
    snugly in the front panel and providing more rigidity
    * Add a somewhat oddly shaped washer, fitting over the left two
    screwholes and along the case wall
    * Tighten the strain relief somewhat
    [ether-bracket.scad]
2023-10-22 add edids for ms2131 boards
2023-10-26 instructions: rebuild with current work-in-progress stuff
2024-01-10 Update graphs
    Fix ethernet cabling loop (teams are provided 2 cables)
    Move HDMI->VGA adapter from presenter to projector/beamer
    Try reordering the nodes a bit (could be a bit better)
2024-01-10 Add laptops to graphs; boxes use USB power
2024-02-20 Add I2C pinout & status poc
    Thanks to Martijn Braam!
2024-03-05 add power board readme
2024-03-05 initial versions of power board kicad files
    [power_board.kicad_pcb, power_board.kicad_sch]
2024-03-05 initial revision of the audio pcb files
    [audio_board.kicad_pcb, audio_board.kicad_sch, codec.kicad_sch, input_balanced.kicad_sch, input_mono.kicad_sch, output_balanced.kicad_sch]
2024-03-07 power_board: schematic for isolated chargers is done
    [isolated_charger.kicad_sch, isolated_chargers.kicad_sch, power_board.kicad_sch, usb_passthrough.kicad_sch]
2024-03-08 power_board: schematic for fan controller
    [fan_controller.kicad_sch, isolated_charger.kicad_sch, power_board.kicad_sch]
2024-03-12 power_board: add temperature sensor and GPIOs to schematic
    [button_and_led.kicad_sch, fan_controller.kicad_sch, gpios.kicad_sch, isolated_charger.kicad_sch, isolated_chargers.kicad_sch, power_board.kicad_sch, power_supply.kicad_sch, temp_sensor.kicad_sch]
2024-03-12 power_board: minor fixes to shematic
    [fan_controller.kicad_sch, gpios.kicad_sch, isolated_charger.kicad_sch, isolated_chargers.kicad_sch, power_board.kicad_sch, power_supply.kicad_sch, temp_sensor.kicad_sch, usb_passthrough.kicad_sch]
2024-03-15 power_board: connect power led to SBC's usb and fix inductor values
    [indicator_leds.kicad_sch, isolated_chargers.kicad_sch, power_board.kicad_sch, power_supply.kicad_sch, usb_passthrough.kicad_sch]
2024-03-17 power_board: finalise all footprints
    [fan_controller.kicad_sch, gpios.kicad_sch, indicator_leds.kicad_sch, isolated_charger.kicad_sch, isolated_chargers.kicad_sch, power_board.kicad_pcb, power_board.kicad_sch, power_supply.kicad_sch]
2024-03-17 power_board: a couple of extra connectors
    [power_board.kicad_sch, power_supply.kicad_sch]
2024-03-17 power_board: arrange front panel components
    [fan_controller.kicad_sch, gpios.kicad_sch, indicator_leds.kicad_sch, isolated_charger.kicad_sch, isolated_chargers.kicad_sch, mechanical.kicad_sch, power_board.kicad_pcb, power_board.kicad_sch]
2024-03-17 power_board: update caps
    [isolated_charger.kicad_sch, mechanical.kicad_sch, power_board.kicad_pcb, power_supply.kicad_sch, temp_sensor.kicad_sch]
2024-03-19 use a sideways usb connector for USB-3
    [fan_controller.kicad_sch, gpios.kicad_sch, indicator_leds.kicad_sch, isolated_charger.kicad_sch, isolated_chargers.kicad_sch, mechanical.kicad_sch, power_board.kicad_pcb, power_board.kicad_sch]
2024-03-21 add DHAN-M module footprint and symbol
    [power_board.kicad_pcb]
2024-03-22 Small audio board fixes and add DHAN-M module
    [audio_board.kicad_pcb, audio_board.kicad_sch, codec.kicad_sch, dect.kicad_sch, input_balanced.kicad_sch, input_mono.kicad_sch, output_balanced.kicad_sch]
2024-03-22 Apply kicad gitignore to all the PCBs
2024-03-22 audio_board: disable thermal spokes on regulator footprint
    [audio_board.kicad_pcb]
2024-04-20 power_board: add power cycler
    [isolated_charger.kicad_sch, power_board.kicad_pcb, power_board.kicad_sch, power_cycler.kicad_sch, power_supply.kicad_sch, temp_sensor.kicad_sch]
2024-04-21 power_board: arrange components for isolated chargers
    [power_board.kicad_pcb]
2024-04-21 power_board: finalise isolated chargers and place USB3 passthrough
    [fan_controller.kicad_sch, gpios.kicad_sch, indicator_leds.kicad_sch, isolated_charger.kicad_sch, isolated_chargers.kicad_sch, mechanical.kicad_sch, power_board.kicad_pcb, power_board.kicad_sch]
2024-04-22 power_board: route signals from current-sensing chips
    [power_board.kicad_pcb]
2024-04-22 Redo layout for the audio board
    * Height of the board decreased by 2cm
    * Switching regulator removed
    * Switched balanced audio I/O for single-rail versions
    [audio_board.kicad_pcb, audio_board.kicad_sch, codec.kicad_sch, input_balanced.kicad_sch, input_mono.kicad_sch, output_balanced.kicad_sch, output_balanced_stereo.kicad_sch]
2024-04-23 Fix balanced audio input voltage label
    [input_balanced.kicad_sch]
2024-04-24 power_board: remove unused caps
    [gpios.kicad_sch, isolated_charger.kicad_sch, isolated_chargers.kicad_sch, power_board.kicad_pcb]
2024-04-27 power_board: arrange stuff on board
    [fan_controller.kicad_sch, gpios.kicad_sch, indicator_leds.kicad_sch, isolated_charger.kicad_sch, isolated_chargers.kicad_sch, mechanical.kicad_sch, power_board.kicad_pcb, power_cycler.kicad_sch]
2024-04-27 power_board: fix drc errors
    [isolated_charger.kicad_sch, power_board.kicad_pcb]
2024-04-27 power_board: finalise silkscreen
    [fan_controller.kicad_sch, gpios.kicad_sch, power_board.kicad_pcb, power_cycler.kicad_sch, power_supply.kicad_sch]
2024-04-27 power_board: some fixes in bom
    [power_supply.kicad_sch]
2024-04-27 Re-route the usb3 differential pairs
    [power_board.kicad_pcb, usb_passthrough.kicad_sch]
2024-04-27 power_board: fix some inconsistencies
    [power_board.kicad_pcb]
2024-04-27 power_board: fix DRC issues
    [power_board.kicad_pcb]
2024-04-27 power_board: final version
    [fan_controller.kicad_sch, gpios.kicad_sch, indicator_leds.kicad_sch, isolated_charger.kicad_sch, isolated_chargers.kicad_sch, power_board.kicad_pcb, power_board.kicad_sch, power_cycler.kicad_sch]
2024-04-29 power_board: some extra fixes
    [fan_controller.kicad_sch, gpios.kicad_sch, indicator_leds.kicad_sch, isolated_charger.kicad_sch, isolated_chargers.kicad_sch, mechanical.kicad_sch, power_board.kicad_pcb, power_board.kicad_sch]
2024-05-21 box_firmware: bootstrap rp2040 firmware from the st7789 pi-pico example
2024-05-21 box_firmware: add network switch status reader boilerplate
2024-05-21 box_firmware: add st7789 SPI library
2024-05-21 box_firmware: use other pico LCD library
2024-05-21 box_firmware: add USB CDC device
2024-05-21 box_firmware: add uart stuff
2024-05-21 box_firmware: setup for reading network switch status
2024-05-21 box_firmware: fix bug with long input lines
    [io_commands.c]
2024-05-21 box_firmware: display text correctly
    [display.c]
2024-05-21 box_firmware: display framebuffer test
2024-05-21 box_firmware: don't do stupid slow stuff when updating framebuffer
2024-05-21 box_firmware: include pico SDK as submodule
2024-05-27 box_firmware: fix a couple of io bugs
    [serial.c, utils.c]
2024-05-27 box_firmware: this was the stupidest bug of all time
    [display.c]
2024-06-01 box_firmware: disable hardware uart by default
2024-06-01 box_firmware: fix several bugs related to displaying images
    [display.c]
2024-06-01 box_firmware: polish display-related uart commands a bit
2024-06-01 box_firmware: fix comment formatting
    [config.h]
2024-06-02 Move 3D printed brackets to a dedicated folder
    [capture-adapter-hagibis.scad, capture-bracket.scad, case-lock.scad, ether-bracket.scad, usb-c-bracket.scad, washer.scad]
2024-06-02 box_firmware: fix some more bugs, displaying images now works
    [display.c]
2024-06-03 Fix BoM for box v2
2024-06-06 audio_board: Rework for DECT plug-in module
    Redesigned the DECT area to accept a daughterboard with whatever DECT
    module ends up working. Added more holes and silkscreen to make the
    board neater.
    [audio_board.kicad_pcb, audio_board.kicad_sch, dect.kicad_sch, input_balanced.kicad_sch, output_balanced_stereo.kicad_sch]
2024-06-07 power_board: nuke general purpose leds and power cycler
    [gpios.kicad_sch, isolated_charger.kicad_sch, isolated_chargers.kicad_sch, power_board.kicad_sch, power_cycler.kicad_sch, power_supply.kicad_sch]
2024-06-07 power_board: make fan controller use 3-pin 5V fans
    [fan_controller.kicad_sch, fan_pwm.kicad_sch]
2024-06-07 power_board: update components to new versions and annotate
    [fan_controller.kicad_sch, fan_pwm.kicad_sch, gpios.kicad_sch, indicator_leds.kicad_sch, isolated_charger.kicad_sch, isolated_chargers.kicad_sch, mechanical.kicad_sch, power_board.kicad_pcb]
2024-06-07 power_board: initial outline
    [fan_controller.kicad_sch, fan_pwm.kicad_sch, isolated_charger.kicad_sch, power_board.kicad_pcb]
2024-06-09 power_board: route the USB connector
    [power_board.kicad_pcb]
2024-06-09 box_firmware: working config for reading network switch
2024-06-09 box_firmware: cleanup network switch-related code and naming
2024-06-09 power_board: route some more components, get closer to finalising shape
    [power_board.kicad_pcb]
2024-06-10 audio_board, power_board: update shop and part links
    [audio_board.kicad_sch, codec.kicad_sch, dect.kicad_sch, fan_controller.kicad_sch, fan_pwm.kicad_sch, gpios.kicad_sch, indicator_leds.kicad_sch, input_balanced.kicad_sch]
2024-06-11 box_firmware: better wiring comments
2024-06-14 power_board: fix TI power chip footprint mask layers
2024-06-14 power_board: arrange route charger units
    [power_board.kicad_pcb]
2024-06-22 Update display and routing for the audio board
2024-06-29 power_board: arrange charger units
    [gpios.kicad_sch, power_board.kicad_pcb]
2024-07-07 power_board: holes with larger keepouts
    [fan_pwm.kicad_sch, mechanical.kicad_sch, power_board.kicad_pcb]
2024-07-07 display_hat: initial drawing
    [display_hat.kicad_pcb, display_hat.kicad_sch]
2024-07-08 switch_board: new PCB
    [rj45.kicad_sch, switch_board.kicad_pcb, switch_board.kicad_sch]
2024-07-08 switch_board: add additional power connector
    [rj45.kicad_sch, switch_board.kicad_pcb, switch_board.kicad_sch]
2024-07-09 hat_pcbs: add radxa hat
    [radxa_hat.kicad_pcb, radxa_hat.kicad_sch]
2024-07-09 power_board: minor adjustments
    [power_board.kicad_pcb]
2024-07-09 box: add wiring diagram (very ugly initial version)
2024-07-14 wiring: remove neutrik connector, correct USB ports
    The HDMI capture card is directly exposed, so remove the extra
    Neutrik. Also swap the USB3_A & USB3_MICRO_B between the power board
    and the Radxa.
2024-07-14 wiring: remove extra whitespace
    I did this in two commits, as to better preserve the earlier changes.
2024-07-14 wiring: add WireViz graph
2024-07-14 wiring: fix markup
    [letter.scad, standembracer.scad]
2024-07-14 wiring: add labels
2024-07-18 power_board: use mta100 power connectors
    [fan_controller.kicad_sch, fan_pwm.kicad_sch, isolated_charger.kicad_sch, power_board.kicad_pcb, power_board.kicad_sch, power_supply.kicad_sch, pwr_connectors.kicad_sch, temp_sensor.kicad_sch]
2024-07-18 power_board: route USB3 connector
    [fan_controller.kicad_sch, fan_pwm.kicad_sch, gpios.kicad_sch, indicator_leds.kicad_sch, mechanical.kicad_sch, power_board.kicad_pcb, power_supply.kicad_sch, pwr_connectors.kicad_sch]
2024-07-19 power_board: final-ish shape
    [fan_controller.kicad_sch, fan_pwm.kicad_sch, gpios.kicad_sch, indicator_leds.kicad_sch, isolated_charger.kicad_sch, isolated_chargers.kicad_sch, mechanical.kicad_sch, power_board.kicad_pcb]
2024-07-19 power_board: re-route USB signals
    [power_board.kicad_pcb]
2024-07-31 Calibrate the dB meters
    The green/yellow treshold is now -10dB and the yellow/red one is 0dB. The whole scale is -60dB to +4dB
2024-08-01 Make control utility fetch names from the Teensy
2024-08-03 power_board: use purpose labels on connectors
    [fan_controller.kicad_sch, gpios.kicad_sch, power_board.kicad_pcb, pwr_connectors.kicad_sch]
2024-08-03 power_board: fix purpose fields
    [power_board.kicad_pcb]
2024-08-03 Audio board revision C
    * Switched the neutrik jacks to NC3FAH2 instead of FAH1 so the jacks
    with an extra ground pin fit (but the FAH1 ones also still fit)
    * Added traces for optional leds (marked DNP)
    * Fixed up the opamp orientation for the XLR outputs
    * Moved the LCD connector to the other side of the board and switched to
    an MTA-100 connector
    [audio_board.kicad_pcb, audio_board.kicad_sch, dect.kicad_sch, input_balanced.kicad_sch, output_balanced.kicad_sch, output_balanced_stereo.kicad_sch]
2024-08-03 power_board: fix fuseholder courtyard
    [power_board.kicad_pcb]
2024-08-03 hats_pcbs: add some connectors
    [radxa_hat.kicad_pcb, radxa_hat.kicad_sch]
2024-08-04 hat_pcbs are almost done
    [display_hat.kicad_pcb, display_hat.kicad_sch, radxa_hat.kicad_pcb, radxa_hat.kicad_sch]
2024-08-05 power_board: final touches
    [isolated_charger.kicad_sch, power_board.kicad_pcb, power_supply.kicad_sch, usb_passthrough.kicad_sch]
2024-08-05 hat_pcbs: add some resistors
    [display_hat.kicad_pcb, display_hat.kicad_sch, radxa_hat.kicad_pcb, radxa_hat.kicad_sch]
2024-08-12 Audio board Rev. C fixes
    * Switch opamp to OPA1678
    * Fix filter resistor on inputs from 22 ohm to 220 ohm
    * Make the board 4 layers for a better ground plane
    * Implement an RC filter for the opamp 5V line
    [audio_board.kicad_pcb, audio_board.kicad_sch, codec.kicad_sch, input_balanced.kicad_sch, input_mono.kicad_sch, output_balanced_stereo.kicad_sch]
2024-08-12 hat_pcbs: cosmetic fixes
    [display_hat.kicad_pcb]
2024-08-13 power_board: BIGGER inductors
    [display_hat.kicad_pcb, indicator_leds.kicad_sch, isolated_chargers.kicad_sch, power_board.kicad_pcb, power_supply.kicad_sch]
2024-08-13 hat_pcbs: final changes
    [display_hat.kicad_pcb, power_board.kicad_pcb, radxa_hat.kicad_pcb]
2024-08-26 pcbs: update purchase info
    [audio_board.kicad_sch, codec.kicad_sch, dect.kicad_sch, display_hat.kicad_sch, fan_controller.kicad_sch, input_balanced.kicad_sch, input_mono.kicad_sch, output_balanced_stereo.kicad_sch]
2024-09-20 switch_board: allow another inductor
    [switch_board.kicad_sch]
2024-09-23 baseplate: add initial version
    [baseplate.scad]
2024-09-24 boards: update boms again
    [audio_board.kicad_sch, gpios.kicad_sch, isolated_charger.kicad_sch, power_supply.kicad_sch, radxa_hat.kicad_sch, switch_board.kicad_pcb]
2024-09-24 boards: add turbocase outlines
    [audio_board.kicad_pcb, power_board.kicad_pcb]
2024-09-24 baseplate: use turbocase-generated boards and drill holes
    [baseplate.scad]
2024-09-24 baseplate: use 2D holes
    [baseplate.scad]
2024-09-24 baseplate: more stable hole difference
    [baseplate.scad]
2024-09-26 boards: update fabrication output settings
    [audio_board.kicad_pcb, display_hat.kicad_pcb, power_board.kicad_pcb, radxa_hat.kicad_pcb, switch_board.kicad_pcb]
2024-09-26 baseplate: precise sizes for radxa x2l
    [baseplate.scad]
2024-10-08 box_firmware: upgrade pico sdk to 2.0.0 and implement some i²c calls
2024-10-08 baseplate: minor fixes
    [baseplate.scad]
2024-10-08 box_firmware: fan control (rudimentary)
2024-10-08 boards: fix many silly bugs discovered during testing
    [audio_board.kicad_pcb, audio_board.kicad_sch, display_hat.kicad_pcb, display_hat.kicad_sch, power_board.kicad_pcb, power_supply.kicad_sch, radxa_hat.kicad_pcb, radxa_hat.kicad_sch]
2024-10-08 baseplate: add cutout for display
    [baseplate.scad]
2024-10-08 display_hat: fix pin order for main connector
    [display_hat.kicad_pcb, display_hat.kicad_sch]
2024-10-08 baseplate: fix some hole spacings
    [baseplate.scad]
2024-10-08 fan controller seems to work
2024-10-08 power_board: add capacitors for filtering fan power supply
    [fan_pwm.kicad_sch, indicator_leds.kicad_sch, isolated_chargers.kicad_sch, mechanical.kicad_sch, power_board.kicad_pcb, power_supply.kicad_sch, pwr_connectors.kicad_sch, temp_sensor.kicad_sch]
2024-10-10 baseplate: add holes under power board to fit inductors
    [baseplate.scad]
2024-10-10 baseplate: split into multiple .scad files
    [audio_board.scad, baseplate.scad, case.scad, display.scad, hdmi.scad, nuts.scad, onlyfans.scad, power_board.scad]
2024-10-10 baseplate: fix radxa x2l holes and move radxa x2l
    [baseplate.scad, radxa_x2l.scad]
2024-10-10 properly position radxa x4
    [baseplate.scad]
2024-10-10 baseplate: some todos
    [case.scad, hdmi.scad, radxa_x2l.scad, radxa_x4.scad]
2024-10-10 use m2.5 holes for radxa x4
    [radxa_x4.scad]
2024-10-10 baseplate: make it a bit shorter to fit in the case
    [case.scad]
2024-10-13 hat_pcbs: update aisler IDs
    [display_hat.kicad_pcb, radxa_hat.kicad_pcb]
2024-10-15 power_board: flip 12V connectors
    [fan_pwm.kicad_sch, power_board.kicad_pcb, power_supply.kicad_sch, pwr_connectors.kicad_sch]
2024-10-16 box_firmware: switch to another TCA9534 library
2024-10-17 baseplate: extrude case
    [case.scad]
2024-10-17 proper dimensions for hdmi capture
    [baseplate.scad, hdmi.scad]
2024-10-17 baseplate: fix radxa measurements
    [baseplate.scad, radxa_x2l.scad, radxa_x4.scad]
2024-10-18 baseplate: add 3D model of case (sorry)
    [baseplate.scad, case.scad, radxa_x2l.scad]
2024-10-18 make baseplate holes align correctly
    [baseplate.scad, case.scad]
2024-10-21 power_board: use USB3-A passthrough connector and fix chg EN
    [fan_controller.kicad_sch, fan_pwm.kicad_sch, gpios.kicad_sch, indicator_leds.kicad_sch, isolated_charger.kicad_sch, isolated_chargers.kicad_sch, power_board.kicad_pcb, power_board.kicad_sch]
2024-10-21 fix powerboard labels
    [power_board.kicad_pcb]
2024-10-21 boards: enable silkscreen references
    [audio_board.kicad_pcb, switch_board.kicad_pcb]
2024-10-22 audio_board, switch_board: fix labels
    [audio_board.kicad_pcb, switch_board.kicad_pcb]
2024-10-22 power_board: minor fixes
    [power_board.kicad_pcb]
2024-10-23 power_board: arrange some stuff
    [power_board.kicad_pcb]
2024-10-23 baseplate: use PCB 3D models for box
    [baseplate.scad, power_board.scad]
2024-10-23 baseplate: show 3D models of hat PCBs
    [baseplate.scad, case.scad, display_hat.kicad_pcb]
2024-10-23 power_board: biggus dickus
    [power_board.kicad_pcb]
2024-10-23 boards: fix minor mistakes and aisler IDs
    [audio_board.kicad_pcb, display_hat.kicad_pcb, radxa_hat.kicad_pcb, switch_board.kicad_pcb]
2024-10-23 power_board: add protection resistor to overload signal
    [fan_controller.kicad_sch, fan_pwm.kicad_sch, gpios.kicad_sch, indicator_leds.kicad_sch, isolated_charger.kicad_sch, isolated_chargers.kicad_sch, power_board.kicad_pcb, power_board.kicad_sch]
2024-10-25 switch_board: update some parts
    [switch_board.kicad_sch]
2024-10-25 audio_board: fix link
    [audio_board.kicad_sch]
2024-10-25 switch_board: minor fixes
    [switch_board.kicad_pcb]
2024-10-26 boards: update mta100 part numbers
    [audio_board.kicad_sch, display_hat.kicad_sch, isolated_charger.kicad_sch, radxa_hat.kicad_sch, switch_board.kicad_sch]
2024-10-26 boards: update some shop links
    [audio_board.kicad_pcb, display_hat.kicad_pcb, power_board.kicad_pcb, radxa_hat.kicad_pcb, switch_board.kicad_pcb]
2024-10-26 boards: update wrong shop links
    [display_hat.kicad_pcb, display_hat.kicad_sch, fan_controller.kicad_sch, gpios.kicad_sch, isolated_charger.kicad_sch, power_board.kicad_pcb, power_supply.kicad_sch, usb_passthrough.kicad_sch]
2024-10-26 baseplate: add some mounting holes for cable ties
    [baseplate.scad]
2024-10-30 brackets: onlyfans & screen
    [onlyfans.scad, screen.scad]
2024-10-30 brackets: add rcube module
    [rcube.scad]
2024-10-30 baseplate: add cable holders
    [baseplate.scad, cable-holder.scad]
2024-10-30 boards: fix minor bom issues
    [audio_board.kicad_sch, output_balanced_stereo.kicad_sch, power_supply.kicad_sch]
2024-11-07 audio_board: implement input level boost
    [audio_board.kicad_pcb, input_balanced.kicad_sch]
2024-11-07 audio_board: bigger hole!
    [audio_board.kicad_pcb]
2024-11-10 box firmware: fan control
    Implement a small algorithm to control the fans via the PWM
    to stay in a specific RPM range.
    The chip should be able to do this by itself, but we never
    managed to get it working, and even the linux-kernel implementation
    does not try to ask the chip to keep specific RPM.
2024-11-13 baseplate: cutouts under audio board for isolation
    [audio_board.scad, baseplate.scad, case.scad]
2024-11-13 baseplate: do not use radxa x2l
    [baseplate.scad]
2024-11-13 baseplate: standoffs
    [audio_board.scad, baseplate.scad, cable-holder.scad, display.scad, hdmi.scad, nuts.scad, onlyfans.scad, power_board.scad]
2024-11-13 baseplate: fix nut holes
    [baseplate.scad, hdmi.scad, nuts.scad, radxa_x4.scad]
2024-11-26 fan_ctl: be able to turn off the fans, so dexterlb can mount them safely
2024-11-27 power_board: proper enable circuit for meanwell power modules
    [fan_controller.kicad_sch, fan_pwm.kicad_sch, gpios.kicad_sch, indicator_leds.kicad_sch, isolated_charger.kicad_sch, isolated_chargers.kicad_sch, power_board.kicad_pcb, power_board.kicad_sch]
2024-11-27 power_board: axe one fan output to make space for caps
    [fan_controller.kicad_sch, fan_pwm.kicad_sch, gpios.kicad_sch, indicator_leds.kicad_sch, mechanical.kicad_sch, power_board.kicad_pcb, power_supply.kicad_sch, pwr_connectors.kicad_sch]
2024-11-27 hat_pcbs: more space under MTA100 connectors as per datasheet
    [display_hat.kicad_pcb, display_hat.kicad_sch, radxa_hat.kicad_pcb, radxa_hat.kicad_sch]
2024-11-27 power_board: minor cosmetic fix
    [fan_controller.kicad_sch]
2024-11-29 power_board: THERE ARE FOUR FANS
    [fan_controller.kicad_sch, fan_pwm.kicad_sch, gpios.kicad_sch, indicator_leds.kicad_sch, mechanical.kicad_sch, power_board.kicad_pcb, power_supply.kicad_sch, pwr_connectors.kicad_sch]
2024-11-29 display_hat: kicad wants to change some property
    [display_hat.kicad_pcb]
2024-11-29 power_board: change uuid
    [power_board.kicad_pcb]
2024-12-04 power_board: use another isolated power module
    [fan_pwm.kicad_sch, indicator_leds.kicad_sch, isolated_charger.kicad_sch, isolated_chargers.kicad_sch, power_board.kicad_pcb, power_board.kicad_sch]
2024-12-04 power_board: update BOM info
    [isolated_chargers.kicad_sch, power_board.kicad_pcb]
2024-12-04 baseplate: move fixing holes to better align with box
    [case.scad]
2024-12-04 baseplate: some final touches
    [baseplate.scad, case.scad, display.scad, hdmi.scad, onlyfans.scad]
2024-12-14 backplate 0.2
    [screenbracket.FCStd]
2024-12-14 backplate laserprep
2024-12-14 bakcplate 0.3 (with poer connector hole)
    [screenbracket.FCStd]
2024-12-14 bakcplate 0.4 cleaned up power connector hole
2024-12-14 remove vertical artifact line on back plate
2024-12-14 fine tunig front plate
2024-12-14 added screen bracket
    [screenbracket-simplified.FCStd]
2024-12-16 added simplified screen bracket
    [screenbracket-2.FCStd]
2024-12-16 added stl files left and right
    [screenbracket-producton-mirror.stl, screenbracket-producton.stl]
2024-12-16 corrected mirroring of mirror screen bracket for easier printinging
    [screenbracket-producton-mirror.stl]
2024-12-16 added text to 2025 front plate
    [screenbracket-2.FCStd]
2024-12-16 added labels and extra hole to backpannel
2024-12-16 moved screwholes in screenbracket 1mm mor appart
    [screenbracket-2.FCStd, screenbracket-producton-mirror.stl, screenbracket-producton.stl]
2024-12-20 fix colours for laser
2024-12-20 back plate: fix colour
2024-12-21 switch hdmi out label and connector
2024-12-21 back panel hdmi out connector slightly lower
2024-12-23 assembly: bootstrap assembly instructions
2024-12-23 assembly: jump-to-item experiment
2024-12-23 assembly: another experiment
2024-12-23 assembly: final experiment
2024-12-23 assembly: some instructions
2024-12-23 assembly: legend
2024-12-23 assembly: saner order
2024-12-23 assembly: bits of sweatshop organization
2024-12-24 assembly: update old box disassembly instructions
2024-12-24 assembly: cable marking instructions
2024-12-24 assembly: fix typo
2024-12-24 assembly: add the mta100 marking steps in the sweatshop
2024-12-27 assembly: add pics
2024-12-27 assembly: some minor modifications
2024-12-27 assembly: clarify
2024-12-28 assembly: fix pic sizes
2024-12-29 assembly: fix display screw size
2024-12-29 assembly: radxa hat can be attached earlier
    We can flash the RP2040 without pressing bootsel:
    https://docs.radxa.com/en/x/x4/software/flash?flash_way=Software
2024-12-29 Move pb.i2c.scan from pwr_brd_ctl to commands
2024-12-29 Move pb.i2c.dump_all_regs from pwr_brd_ctl to commands
2024-12-29 Change max fan RPM so that it's achievable
2024-12-29 Add edge case for zero fan RPM
2024-12-29 Rework fan control algorithm
    - calculate next command time instead of saving the last one
    - cap the PWM output
    - add delay when spinning down the fans so that a correct RPM can be measured
    - update algorithm documentation
2024-12-30 Split thresholds to lower and upper to prevent fan stalling
2024-12-30 Fix slow PWM decrease on boot
2025-01-03 assembly: fix to match what was actually done
2025-01-03 assembly: add display
2025-01-08 Implement exponential smoothing for fan control
    The current values in combination with the update rate will ensure the
    fan does the same anti-stall behavior and its at PWM speed 3 for the
    default 5000rpm setting
2025-01-13 box_firmware: proper direction for charger pin
2025-01-28 audio_board: extract teensy audio
    - move teensy audio to `teensyaudio.h`
    - allow bus and channel multipliers, appiled to the virtual mixer-matrix
2025-01-28 audio_board: add info endpoint
    - add `/info` endpoint that reports the mixer configuration
    - add `USE_` prefix to config macros, as DISPLAY is used by the teensy
    lib
2025-01-28 audio_board: replace pointers with references
    [display.h]
2025-01-28 audio_board: fix blank display bug
    [display.h]
2025-01-28 firmware: audio_board: enable SerialUSB1
    Teensy doesn't ship with a configuration with multiple serial ports and audio I/O so this adjusts the current one to have more serial ports
2025-01-28 audio_board: dump crash report to debug uart on boot
2025-02-02 Fix typos discovered by codespell
    [hdmi.scad, power_board.kicad_pcb]
2025-02-13 box_firmware: replace fan control algorithm again
2025-02-26 audio_board: switch vendor/cores to upstream
2025-02-26 audio_board: switch vendor/Audio to upstream
2025-03-08 Implement basic VLAN support for the FOSDEM switch
2025-05-04 add xlr tester pcb
    [ac_filter.kicad_sch, dc_filter.kicad_sch, inputs.kicad_sch, power.kicad_sch, xlr_tester_pcb.kicad_pcb, xlr_tester_pcb.kicad_sch]
2025-06-10 move xlr_tester to audio_experiments/
    [ac_filter.kicad_sch, dc_filter.kicad_sch, inputs.kicad_sch, power.kicad_sch, xlr_tester_pcb.kicad_pcb, xlr_tester_pcb.kicad_sch]
2025-06-10 add taa3040 experiment board
    [balanced_input.kicad_sch, balanced_transformer_input.kicad_sch, conn_and_power.kicad_sch, input_frontend.kicad_sch, mv2_taa3040.kicad_pcb, mv2_taa3040.kicad_sch]
2025-06-10 replicate frontend layout
    [mv2_taa3040.kicad_pcb]
2025-06-10 test pcb almost done
    [balanced_transformer_input.kicad_sch, input_frontend.kicad_sch, mv2_taa3040.kicad_pcb]
2025-06-11 add mv2 baseboard
    [mv2_base.kicad_pcb, mv2_base.kicad_sch]
2025-06-12 finalise board
    [balanced_input.kicad_sch, balanced_transformer_input.kicad_sch, conn_and_power.kicad_sch, input_frontend.kicad_sch, mv2_taa3040.kicad_pcb, mv2_taa3040.kicad_sch]
2025-07-02 Add WIP dual capture device PCB
    [Power.kicad_sch, audio.kicad_sch, fosdem-dual-capture.kicad_pcb, fosdem-dual-capture.kicad_sch, hdmi_switch.kicad_sch, mcu.kicad_sch, ms2131.kicad_sch, usb_hub.kicad_sch]
2025-08-08 update bom
    [balanced_input.kicad_sch, conn_and_power.kicad_sch, input_frontend.kicad_sch, mv2_taa3040.kicad_pcb, mv2_taa3040.kicad_sch]
2025-09-19 hardware: improved fan bracket
    [onlyfans-baseplate.scad]
2025-10-20 All parts placed
    [adc.kicad_sch, audio_board.kicad_pcb, audio_board.kicad_sch, power.kicad_sch, xlr_input.kicad_sch]
2025-10-26 schematic cosmetics
    [adc.kicad_sch, audio_board.kicad_pcb, audio_board.kicad_sch, dac.kicad_sch, dect.kicad_sch, input_mono.kicad_sch, power.kicad_sch, xlr_input.kicad_sch]
2025-10-26 fix libraries
    [adc.kicad_sch, audio_board.kicad_pcb, audio_board.kicad_sch, dac.kicad_sch, dect.kicad_sch, input_mono.kicad_sch, power.kicad_sch, xlr_input.kicad_sch]
2025-10-26 final touches to libraries
    [audio_board.kicad_pcb, audio_board.kicad_sch, power.kicad_sch]
2025-10-26 some placement
    [audio_board.kicad_pcb]
2025-10-27 audio board
    [audio_board.kicad_pcb]
2025-10-27 add vias and mask to ic packages and route dac
    [adc.kicad_sch, audio_board.kicad_pcb, power.kicad_sch]
2025-10-27 route one input
    [audio_board.kicad_pcb]
2025-10-27 route all ADC inputs
    [audio_board.kicad_pcb]
2025-10-28 some more routing
    [adc.kicad_sch, audio_board.kicad_pcb, audio_board.kicad_sch, dac.kicad_sch, dect.kicad_sch, input_mono.kicad_sch, power.kicad_sch, xlr_input.kicad_sch]
2025-10-28 route some more
    [adc.kicad_sch, audio_board.kicad_pcb, audio_board.kicad_sch, dac.kicad_sch, input_mono.kicad_sch, power.kicad_sch, xlr_input.kicad_sch]
2025-10-28 routing almost complete
    [adc.kicad_sch, audio_board.kicad_pcb, dac.kicad_sch, dect.kicad_sch, input_mono.kicad_sch, power.kicad_sch, xlr_input.kicad_sch]
2025-10-29 fix XLR courtyard
    [audio_board.kicad_pcb, audio_board.kicad_sch]
2025-10-29 connect some items
    [audio_board.kicad_pcb]
2025-10-29 finish routing
    [audio_board.kicad_pcb, audio_board.kicad_sch, dac.kicad_sch, input_mono.kicad_sch, power.kicad_sch, xlr_input.kicad_sch]
2025-10-29 update font size for references
    [audio_board.kicad_pcb]
2025-10-29 more font fixes
    [audio_board.kicad_pcb]
2025-10-29 component values
    [adc.kicad_sch, audio_board.kicad_sch, dac.kicad_sch, dect.kicad_sch, input_mono.kicad_sch, power.kicad_sch, xlr_input.kicad_sch]
2025-10-30 revise BOM
    [adc.kicad_sch, audio_board.kicad_pcb, audio_board.kicad_sch, dac.kicad_sch, input_mono.kicad_sch, power.kicad_sch, xlr_input.kicad_sch]
2025-10-30 some silkscreen
    [audio_board.kicad_pcb]
2025-10-30 fix all silkscreens
    [audio_board.kicad_pcb, audio_board.kicad_sch, input_mono.kicad_sch]
2025-10-30 finish silkscreens
    [audio_board.kicad_pcb, audio_board.kicad_sch, dect.kicad_sch]
2025-10-30 slew rate limiting resistors
    [audio_board.kicad_pcb, audio_board.kicad_sch, dac.kicad_sch, input_mono.kicad_sch, power.kicad_sch, xlr_input.kicad_sch]
2025-10-30 add XLR logo
    [audio_board.kicad_pcb]
2025-10-30 final touches before production
    [audio_board.kicad_pcb, audio_board.kicad_sch, dect.kicad_sch]
2025-11-15 fix mistakes in audioboard design
    [audio_board.kicad_pcb, audio_board.kicad_sch, dac.kicad_sch, xlr_input.kicad_sch]
2025-11-15 bump revision
    [audio_board.kicad_pcb]
2025-11-15 properly change revision
    [audio_board.kicad_pcb]
2025-11-15 remove ethernet header
    [audio_board.kicad_pcb, audio_board.kicad_sch]
2025-11-15 final run
    [adc.kicad_sch, audio_board.kicad_pcb, audio_board.kicad_sch, dac.kicad_sch, input_mono.kicad_sch, power.kicad_sch, xlr_input.kicad_sch]
2025-11-15 I have no idea what this is
    [audio_board.kicad_pcb]
2025-11-17 final fixes on audio board
    [adc.kicad_sch, audio_board.kicad_pcb, dac.kicad_sch, input_mono.kicad_sch, xlr_input.kicad_sch]
2025-11-18 fix audioboard phantom power and some labels
    [audio_board.kicad_pcb, input_mono.kicad_sch, power.kicad_sch, xlr_input.kicad_sch]
2026-01-04 instructions: note on the cable with internet connectivity
2026-02-20 Use ADC gain for the input multiplier
2026-03-21 arduino is hell
2026-03-21 remove obsolete canon camera stuff
2026-03-21 debug print infra
2026-04-17 standoffs for mounting two hagibis
    [baseplate.scad, standoffs-hagibi.scad]
2026-05-08 audioctl_ui: pin misirka
2026-07-30 Implement network switch vlan configuration over the serial port
2026-08-06 Update codegen for teensyaudio_generated.cpp
2026-08-06 fix warnings and a couple of bugs
    [teensyaudio_defaults.h]
2026-08-06 wire up all the actions
2026-08-06 Full EQ filter implementation
2026-08-06 refactor audioctl_ui a bit and add factory reset button
2026-08-06 implement persist button for audioctl
2026-08-06 fix aes channel names
    [channel_info.cpp]
2026-08-06 fix peak levels bug
    [channel.cpp]
2026-08-22 Pulse the phantom power a few times on boot on pins that don't support PWM
2026-08-22 more elaborate soft pwm
2026-08-22 I hate arduino
